Johnlon/spam-1/docs/rom-research.md

# ROM Research

Looking for large 16 bit wide ROM's for control logic and ALU purposes.

|Model|Description|Access|VCC Voltage|V other|Bit Address|Package|Link|
|---|---|---|-----|----|---|--|----|----|
|S29GL128S90TFI010|128 Mbit, 8M x 16bit, Parallel|100ns|3v abs max 4v|VSS+0.5|26 = 128MB, also 64/32/16MB options||TSOP, 56 Pins|https://uk.farnell.com/cypress-semiconductor/s29gl128s90tfi010/memory-flash-128mbit-56tsop/dp/2136248|
| | |  | | | | |https://www.mouser.co.uk/datasheet/2/671/MT28EW_QLLP_01G_ABA_0SIT-1287008.pdf

64k x 16 static ram - https://www.mouser.co.uk/datasheet/2/100/38-05462_CY7C1021D_1_MBIT_64K_X_16_STATIC_RAM-319200.pdf
