Johnlon/spam-1/docs/SimpleCpu-blocks-20200520.pptx

ALU A
Bus

_oe

A[15:0]

D[48:0]

ROM

D[7:0]

IMMEDIATE
ADDRESSSING

A

CONTROL LOGIC

D[48:8]

_wr
_oe

A[15:0]

RAM

BUFFER IN
_en

PCHITmp

CP

D

_en

Q

count_en
_pe

CP

D

PCHI

_MR

CP

count_en
_pe

D

PCLO

_MR

CP

D

_en

MARHI

BUFFER A
_en

MARLO

CP

D

_en

BUFFER A
_en

wr
_rd

UART

_txe
_rxf

BUFFER IN
_en

CONTROL LOGIC

BUFFER A
_en

CP

D

_MR

L

FLAGS

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
_cin

ALU

Address Bus [15:0]

D

Q

Q

Q

BUFFER AH
_en

Q

BUFFER AL
_en

D

rdL_addr
rdR_addr
wr_addr
_rdL_en
_rdR_en
_wr_en

SYNC
REG FILE

CONTROL
LOGIC

Result

PC [15:0]

BUFFER B
_en

D[24:16]

BUFFER AH
_en

BUFFER B
_en

BUFFER B
_en

BUFFER B
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
ALU B
Bus

B

DIRECT
ADDRESS HI

D[15:8]

BUFFER AL
_en

DIRECT
ADDRESS LO

PC [15:0]

REGISTER ADDRESS HI

REGISTER ADDRESS LO

Address Bus Hi [15:8]

Address Bus Lo [7:0]

8 Bit CPU Design

## Slide 2

ALU Result Bus

ALU A
Bus

_oe

A[15:0]

D[48:0]

ROM

D[7:0]

IMMEDIATE
ADDRESSSING

ram_alubus_buf

BUFFER IN
_en

marhi_abus_buf

marlo_abus_buf

BUFFER A
_en

uart_alubus_buf

uart_abus_buf

A

CONTROL LOGIC

BUFFER A
_en

BUFFER IN
_en

CONTROL LOGIC

BUFFER A
_en

PC [15:0]

ALU B
Bus

D[48:8]

_wr
_oe

A[15:0]

RAM

PCHITmp

CP

D

_en

Q

count_en
_pe

CP

D

PCHI

_MR

CP

count_en
_pe

D

PCLO

_MR

CP

D

_en

MARHI

MARLO

CP

D

_en

wr
_rd

UART

_txe
_rxf

rdL_addr
rdR_addr
wr_addr
_rdL_en
_rdR_en
_wr_en

CP

D

_MR

SYNC
REG FILE

L

FLAGS

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
_cin

ALU

Address Bus [15:0]

D

Q

Q

Q

BUFFER AH
_en

Q

BUFFER AL
_en

D

R

CONTROL
LOGIC

Result

BUFFER B
_en

BUFFER AH
_en

BUFFER B
_en

ram_bbus_buf

BUFFER B
_en

BUFFER B
_en

Optional extras: a presettable auto-counting MAR?
Or a settable address register that autoincrements after each read will save time on copy operations; otherwise multiple instructions required for increment, with carry to MARHI.
Basically a second program counter-like thing.
Dedicated stack pointer?.

C
Z
O
GT
LT
EQ
NE

rom_bbus_buf

BUFFER AL
_en

marhi_bbus_buf

REGISTER ADDRESS HI

marhi_addrbushi_buf

marhi_bbus_buf

REGISTER ADDRESS LO

B

DIRECT
ADDRESS HI

rom_addrbushi_buf

D[24:16]

D[15:8]

DIRECT
ADDRESS LO

rom_addrbuslo_buf

PC [15:0]

Address Bus Hi [15:8]

marlo_addrbuslo_buf

Address Bus Lo [7:0]

## Slide 3

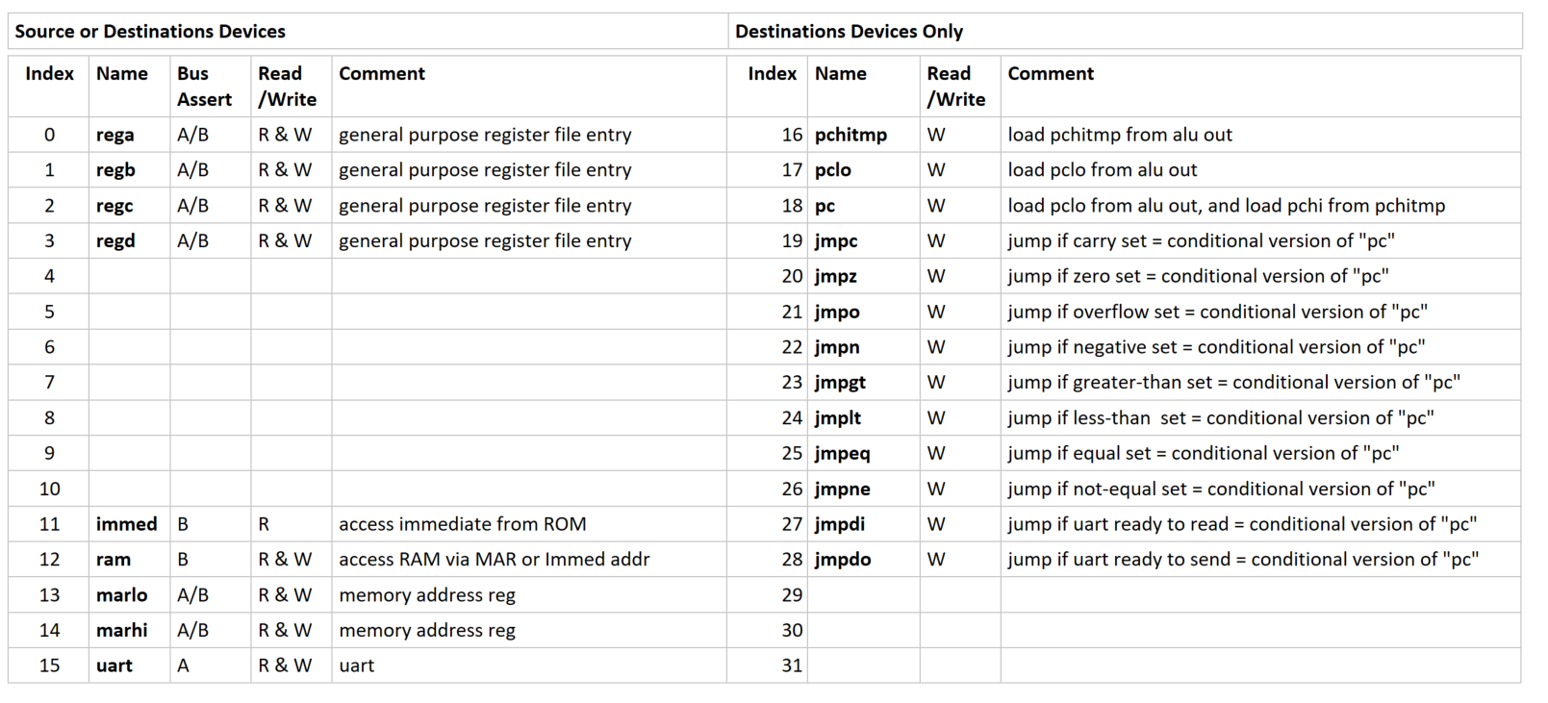
[picture p21: figure]

## Slide 4


## Slide 5

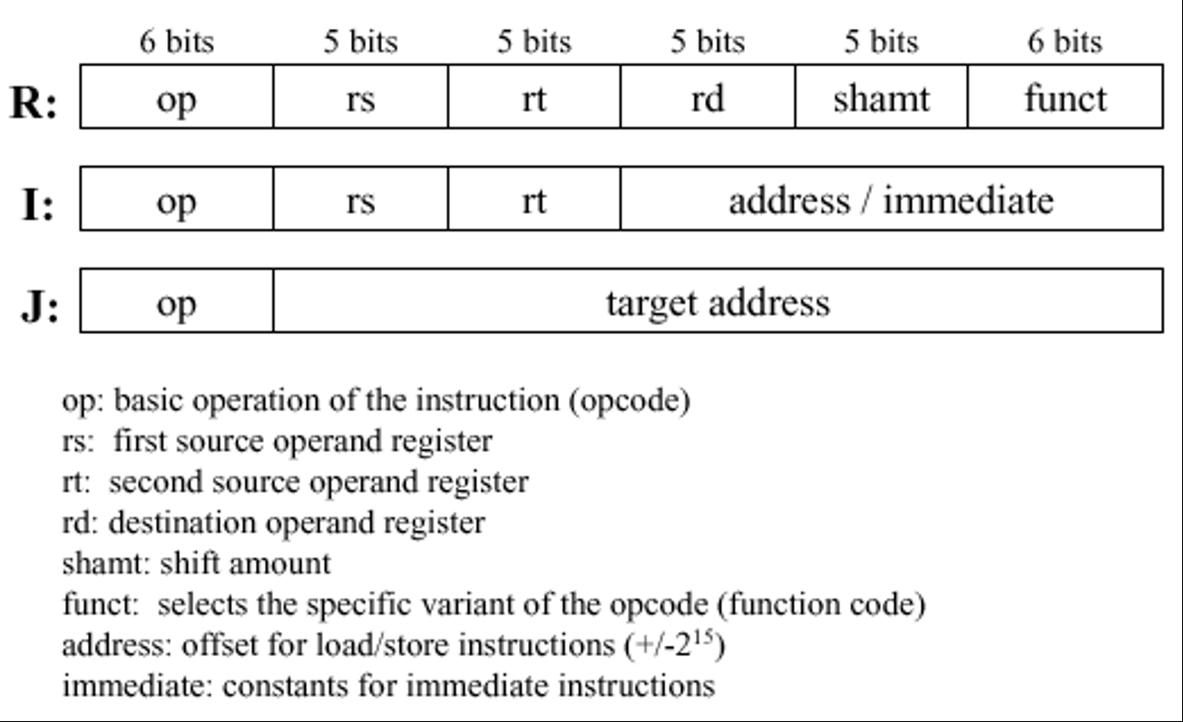
[picture p22: figure]

## Slide 6

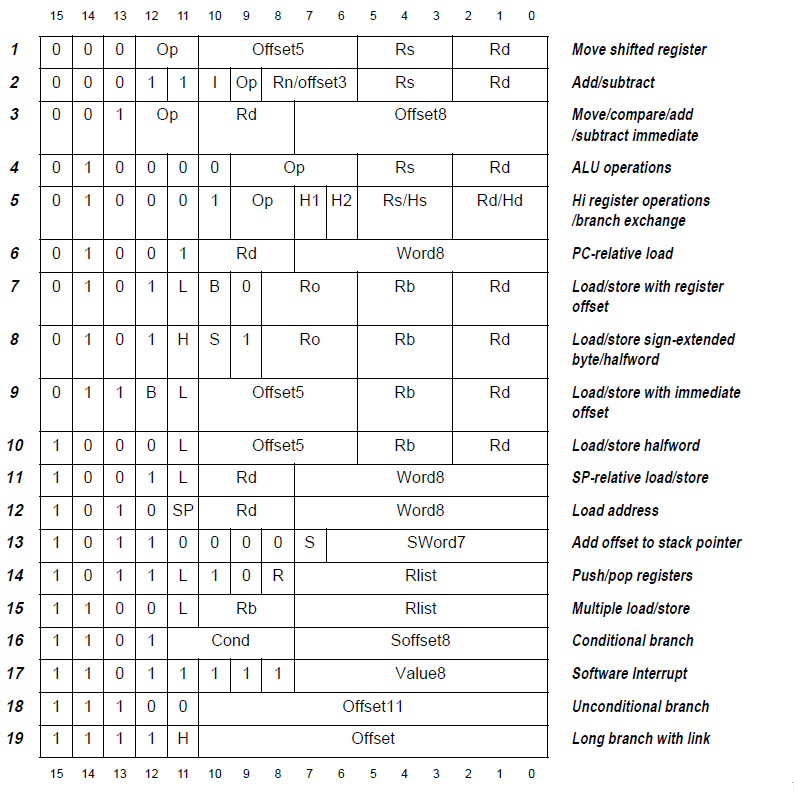
[picture p23: figure]
The art of emulation: Decoding the THUMB instruction set

## Slide 7

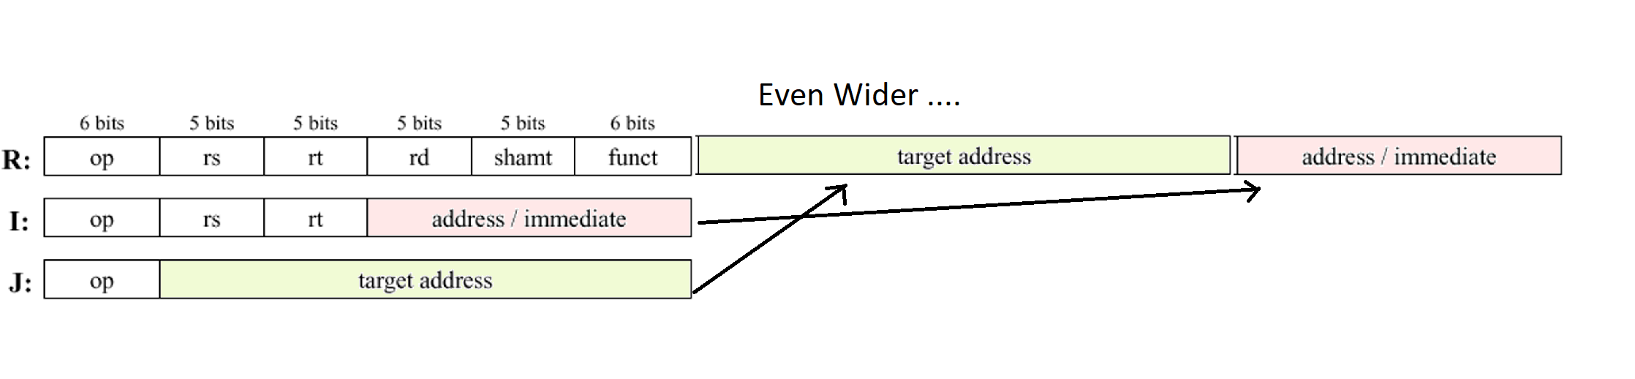
[picture p24: figure]
Even Wider J: op target address
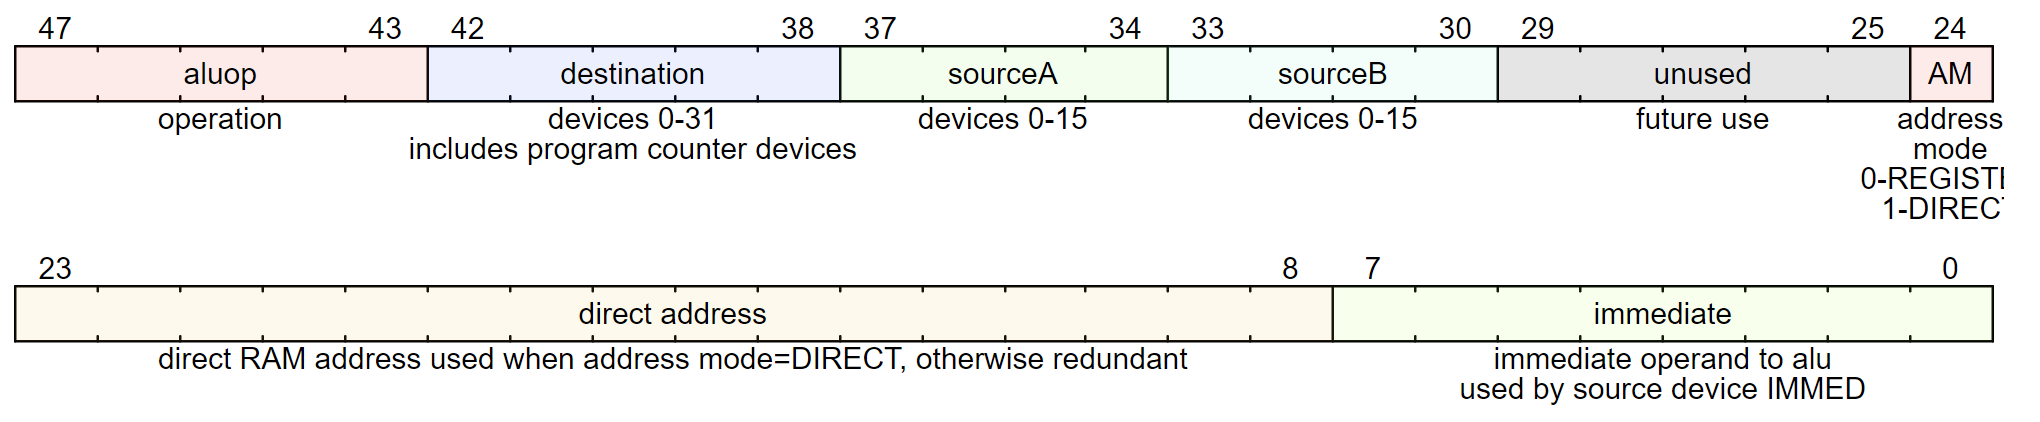
[picture p25: figure]
47 43 aluop operation 42 destination devices 0-31 38 37 34 33 sourced devices 0-1 30 29 25 24 AM devices 0-15 includes program counter devices direct address direct RAM address used when address mode-DIRECT otherwise redundant unused future use immediate address O-REGISTI I-DIREC immediate operand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

## Slide 8

Useful?? 74als576 – inverting dtype – oe + clk + bus layout
74HC7292 clock divider 4> 2billion – good for clock speed control off a fast crystal or for a freq counter - https://uk.rs-online.com/web/p/clock-dividers/5400461/

CAN NOT DO “RAM ALU IMMED” AS BOTH USE RBUS ONLY!

Horizontal Encoded “WIDE ROM” Design

Optional : Flags reg on A Bus means we can store it
to RAM or to another reg and do arbitrary bitwise comparisons on the result.
Optional: But if we also allow it to be restored from RAM or a REG or ROM then that
might be extra useful – eg to set or clear carry before arithmetic.
Or is Carry a special case? Perhaps on a sophisticated CPU
stashing the flags might be useful, but here?

General conditional instruction?
Set flags control like ARM?

RAM isolation from result bus to avoid read / write or RAM leaking between Result Bus and B Bus.
Buffer I _oe = _wr
Buffer B _oe = _RAM _oe

ALU Result Bus

ALU A Bus

ram_alubus_buf

marhi_abus_buf

marlo_abus_buf

uart_alubus_buf

uart_abus_buf

A

_oe

A[15:0]

D[48:0]

ROM

CONTROL LOGIC

D[48:8]

BUFFER IN
_en

BUFFER A
_en

BUFFER A
_en

BUFFER IN
_en

CONTROL LOGIC

UART Buffer isolation needed to prevent writes and reads from UART on one bus leaking over to the other bus.
Buffer IN _oe = wr
Buffer A _oe = _rd
(wr is +ve edge latch)

BUFFER A
_en

TBD: Flags Reg
write _en may only be enabled for specific ops

FLAGS

BUFFER A
_en`

PC [15:0]

_wr
_oe

A[15:0]

PCHITmp

CP

D

_en

Q

count_en
_pe

CP

D

PCHI

_MR

count_en
_pe

CP

D

PCLO

_MR

MARHI

CP

D

_en

MARLO

CP

D

_en

wr
_rd

UART

Register file is a general
purpose register set

rdL_addr
rdR_addr
wr_addr
_rdL_en
_rdR_en
_wr_en

CP

D

_MR

SYNC
REG FILE

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
_cin

ALU

Address Bus [15:0]

RAM

D

Q

Q

MAR primary function is Address Bus index.
Optionally MAR can join either/both A Bus
or B Bus depending
on flexibility desired.
So MAR also acts as a GP register on both ALUinput busses.

Q

BUFFER AH
_en

Q

BUFFER AL
_en

_txe
_rxf

D

R

CONTROL LOGIC

Result

Immediate
addressing
buffer

D[7:0]

BUFFER B
_en

ALU B Bus

rom_bbus_buf

D[24:16]

BUFFER AH
_en

BUFFER B
_en

ram_bbus_buf

PCHI/LO Primary function is Address Bus index.
Optionally PC can join either/both A Bus or B Bus depending on whether I want to permit PC arithmetic.
Here PC is shown outputting to
A Bus.

BUFFER B
_en

BUFFER B
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
BUFFER AL
_en

marhi_bbus_buf

MARHI

marhi_bbus_buf

Optional extras: a presettable auto-counting MAR?
Or a settable address register that autoincrements after each read will save time on copy operations; otherwise multiple instructions required for increment, with carry to MARHI. Basically a second program counter like thing.
And I have no dedicated stack pointer either.

B

DIRECTHI

rom_addrbushi_buf

D[15:8]

DIRECTLO

rom_addrbuslo_buf

Attach RAM /ROM to
R Bus so they can
participate in ALU
as other side from
the other registers
Or UART.

PC [15:0]

_oe=_addrmode_register

MARLO

Address Bus Hi [15:8]

CANNOT READ PROGRAM COUNTER : NOT NEEDED IN STATIC PROGRAM

marhi_addrbushi_buf

marlo_addrbuslo_buf

USE 40 pin ribbon and connector for busses?
20 pin for connector + 4x10 pin for chips = 60
Remaining 3 pins for caps? Or spacing?? Very tight.
So instead use the approach in the

Address Bus Lo [7:0]

BUS RIBBON CONNECTOR https://uk.rs-online.com/web/p/products/0471389/

GS100 bus stripx2 $3.45 https://www.globalspecialties.com/solderless-breadboards/breadboards-bus-strips/item/34-gs-100.html
£3.28 https://www.mouser.co.uk/ProductDetail/Global-Specialties/GS-100?qs=uv8bPZ39CeNa73a0uSX5Lw%3D%3D
BB100R is the busboard equiv
£2.70 https://www.digikey.co.uk/product-detail/en/global-specialties/GS-100/BKGS-100-ND/5231302

## Slide 9

RAM isolation from result bus to avoid read / write or RAM leaking between Result Bus and B Bus.
Buffer I _oe = _wr
Buffer B _oe = _RAM _oe

ALU Result Bus

Optional : Flags reg on A Bus means we can store it
to RAM or to another reg and do arbitrary bitwise comparisons on the result.
Optional: But if we also allow it to be restored from RAM or a REG or ROM then that
might be extra useful – eg to set or clear carry before arithmetic.
Or is Carry a special case? Perhaps on a sophisticated CPU
stashing the flags might be useful, but here?

ALU A Bus

ram_alubus_buf

pchi_abus_buf

pclo_abus_buf

marhi_abus_buf

marlo_abus_buf

uart_alubus_buf

uart_abus_buf

A

_oe

A[15:0]

D[48:0]

ROM

CONTROL LOGIC

D[48:8]

BUFFER IN
_en

BUFFER A
_en

BUFFER A
_en

BUFFER A
_en

BUFFER A
_en

BUFFER IN
_en

CONTROL LOGIC

UART Buffer isolation needed to prevent writes and reads from UART on one bus leaking over to the other bus.
Buffer IN _oe = wr
Buffer A _oe = _rd
(wr is +ve edge latch)

BUFFER A
_en

TBD: Flags Reg
write _en may only be enabled for specific ops

FLAGS

BUFFER A
_en`

PC [15:0]

_wr
_oe

A[15:0]

PCHITmp

CP

D

_en

Q

count_en
_pe

CP

D

PCHI

_MR

count_en
_pe

CP

D

PCLO

_MR

MARHI

CP

D

_en

MARLO

CP

D

_en

wr
_rd

UART

Register file is a general
purpose register set

rdL_addr
rdR_addr
wr_addr
_rdL_en
_rdR_en
_wr_en

CP

D

_MR

SYNC
REG FILE

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
_cin

ALU

Address Bus [15:0]

RAM

D

Q

Q

MAR primary function is Address Bus index.
Optionally MAR can join either/both A Bus
or B Bus depending
on flexibility desired.
So MAR also acts as a GP register on both ALUinput busses.

Q

BUFFER AH
_en

Q

BUFFER AL
_en

_txe
_rxf

D

R

CONTROL LOGIC

Result

Immediate
addressing
buffer

D[7:0]

BUFFER B
_en

ALU B Bus

rom_bbus_buf

D[24:16]

BUFFER AH
_en

BUFFER B
_en

ram_bbus_buf

PCHI/LO Primary function is Address Bus index.
Optionally PC can join either/both A Bus or B Bus depending on whether I want to permit PC arithmetic.
Here PC is shown outputting to
A Bus.

BUFFER B
_en

BUFFER B
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
BUFFER AL
_en

marhi_bbus_buf

MARHI

marhi_bbus_buf

Optional extras: a presettable auto-counting MAR?
Or a settable address register that autoincrements after each read will save time on copy operations; otherwise multiple instructions required for increment, with carry to MARHI. Basically a second program counter like thing.
And I have no dedicated stack pointer either.

B

DIRECTHI

rom_addrbushi_buf

D[15:8]

DIRECTLO

rom_addrbuslo_buf

Attach RAM /ROM to
R Bus so they can
participate in ALU
as other side from
the other registers
Or UART.

PC [15:0]

_oe=_addrmode_register

MARLO

Address Bus Hi [15:8]

marhi_addrbushi_buf

marlo_addrbuslo_buf

Address Bus Lo [7:0]

## Slide 10

~~This design doesn’t permit~~
~~X=Y+KONST~~ ~~or worse perhaps~~
~~X = X~~ ~~logicialOp~~ ~~KONST~~ FIXED

Use unused op 2 or 3 for that?
If not enough bit space then do X=X+5 so targ is fixed to src OR only permit lower 16 ALU ops HMM Bad for logic ops.
OR only allow 3 bits for src and/or targ so we can only do that with GP registers ??
Targ fixed to src is probably ok for many logical ops??

74als576 – inverting dtype – oe + clk + bus layout
74HC7292 clock divider 4> 2billion – good for clock speed control off a fast crystal or for a freq counter - https://uk.rs-online.com/web/p/clock-dividers/5400461/

Horizontal Encoded “WIDE ROM” Design

Optional : Flags reg on A Bus means we can store it
to RAM or to another reg and do arbitrary bitwise comparisons on the result.
Optional: But if we also allow it to be restored from RAM or a REG or ROM then that
might be extra useful – eg to set or clear carry before arithmetic.
Or is Carry a special case? Perhaps on a sophisticated CPU
stashing the flags might be useful, but here?

RAM isolation from result bus to avoid read / write or RAM leaking between Result Bus and B Bus.
Buffer I _oe = _wr
Buffer B _oe = _RAM _oe

ALU Result Bus

ALU A Bus

ram_alubus_buf

pchi_abus_buf

pclo_abus_buf

marhi_abus_buf

marlo_abus_buf

uart_alubus_buf

uart_abus_buf

A

Raw {PCHI, PCLO}

PC [15:0]

Address Bus
multiplexes
{PCHI, PCLO}
{MARHI, MARLO}
{DIRECTHI, DIRECTLO}

_oe

A[15:0]

D[48:8]

ROM

_oe

A D[7:0]

ROM

CONTROL LOGIC

BUFFER IN
_en

BUFFER A
_en

BUFFER A
_en

BUFFER A
_en

BUFFER A
_en

BUFFER IN
_en

CONTROL LOGIC

UART Buffer isolation needed to prevent writes and reads from UART on one bus leaking over to the other bus.
Buffer IN _oe = wr
Buffer A _oe = _rd
(wr is +ve edge latch)

BUFFER A
_en

TBD: Flags Reg
write _en may only be enabled for specific ops

FLAGS

BUFFER A
_en`

D[48:8]

Address Bus

_wr
_oe

A[15:0]

PCHITmp

CP

D

_en

Q

count_en
_pe

CP

D

PCHI

_MR

count_en
_pe

CP

D

PCLO

_MR

MARHI

CP

D

_en

MARLO

+ve edge Registers but could be latches if the output of the ALU is a register

CP

D

_en

wr
_rd

UART

Register file is a general
purpose register set

rdL_addr
rdR_addr
wr_addr
_rdL_en
_rdR_en
_wr_en

CP

D

_MR

SYNC
REG FILE

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
_cin

ALU

Address Bus [15:0]

D[7:0]

Instruction Reg
for low byte

IReg Lo
_en

RAM

D

Q

Q

MAR primary function is Address Bus index.
Optionally MAR can join either/both A Bus
or B Bus depending
on flexibility desired.
So MAR also acts as a GP register on both ALUinput busses.

Q

BUFFER AH
_en

Q

BUFFER AL
_en

_txe
_rxf

D

R

CONTROL LOGIC

Result

Direct
addressing
buffer

BUFFER B
_en

ALU B Bus

rom_bbus_buf

D[7:0]

D[24:16]

BUFFER AH
_en

BUFFER B
_en

Immediate
addressing
buffer

BUFFER B
_en

ram_bbus_buf

PCHI/LO Primary function is Address Bus index.
Optionally PC can join either/both A Bus or B Bus depending on whether I want to permit PC arithmetic.
Here PC is shown outputting to
A Bus.

BUFFER B
_en

BUFFER B
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
BUFFER AL
_en

instreg_bbus_buf

marhi_bbus_buf

MARHI

marhi_bbus_buf

Optional extras: a presettable auto-counting MAR?
Or a settable address register that autoincrements after each read will save time on copy operations; otherwise multiple instructions required for increment, with carry to MARHI. Basically a second program counter like thing.
And I have no dedicated stack pointer either.

B

DIRECTHI

rom_addrbushi_buf

D[15:8]

_oe=_addrmode_immediate

DIRECTLO

rom_addrbuslo_buf

Attach RAM /ROM to
R Bus so they can
participate in ALU
as other side from
the other registers
Or UART.

PCHI

pchi_addrbushi_buf

BUFFER AH
_en

BUFFER AL
_en

_oe=_addrmode_pc

PCLO

pclo_addrbuslo_buf

_oe=_addrmode_register

MARLO

Address Bus Hi [15:8]

marhi_addrbushi_buf

marlo_addrbuslo_buf

Address Bus Lo [7:0]

GS100 bus stripx2 $3.45 https://www.globalspecialties.com/solderless-breadboards/breadboards-bus-strips/item/34-gs-100.html
£3.28 https://www.mouser.co.uk/ProductDetail/Global-Specialties/GS-100?qs=uv8bPZ39CeNa73a0uSX5Lw%3D%3D
BB100R is the busboard equiv
£2.70 https://www.digikey.co.uk/product-detail/en/global-specialties/GS-100/BKGS-100-ND/5231302

## Slide 11

This design doesn’t permit
X=Y+KONST or worse perhaps
X = X logicialOp KONST FIXED

Use unused op 2 or 3 for that?
If not enough bit space then do X=X+5 so targ is fixed to src OR only permit lower 16 ALU ops HMM Bad for logic ops.
OR only allow 3 bits for src and/or targ so we can only do that with GP registers ??
Targ fixed to src is probably ok for many logical ops??

74als576 – inverting dtype – oe + clk + bus layout
74HC7292 clock divider 4> 2billion – good for clock speed control off a fast crystal or for a freq counter - https://uk.rs-online.com/web/p/clock-dividers/5400461/
FIX NAMES IMMEDIATE/DIRECT/REGISTER
CONTROL LOGIC EASIER IF ALL DEVICES CAN WRITE TO RBUS OR LBUS AS DON’T NEED TO FORCE L AND R JUST ONE OR THE OTHER

CAN’T DO “RAM ALU IMMED” AS BOTH USE RBUS ONLY!

Clock Circuit with Break - http://tinyurl.com/y3ygr5yr

Horizontal Encoded “WIDE ROM” Design

Optional : Flags reg on L Bus means we can store it
to RAM or to another reg and do arbitrary bitwise comparisons on the result.
Optional: But if we also allow it to be restored from RAM or a REG or ROM then that
might be extra useful – eg to set or clear carry before arithmetic.
Or is Carry a special case? Perhaps on a sophisticated CPU
stashing the flags might be useful, but here?

RAM isolation from result bus to avoid read / write or RAM leaking between Result Bus and R Bus.
Buffer I _oe = _wr
Buffer R _oe = _RAM _oe

ALU Result Bus

ALU A Bus

ram_alubus_buf

pchi_abus_buf

pclo_abus_buf

marhi_abus_buf

marlo_abus_buf

uart_alubus_buf

uart_abus_buf

A

Raw {PCHI, PCLO}

PC [15:0]

Address Bus
multiplexes
{PCHI, PCLO}
{MARHI, MARLO}
{DIRECTHI, DIRECTLO}

_oe

A[15:0]

D[48:8]

ROM

_oe

A D[7:0]

ROM

CONTROL LOGIC

BUFFER I
_en

BUFFER A
_en

BUFFER A
_en

BUFFER A
_en

BUFFER A
_en

BUFFER I
_en

CONTROL LOGIC

UART Buffer isolation needed to prevent writes and reads from UART on one bus leaking over to the other bus.
Buffer I _oe = wr
Buffer L _oe = _rd
(wr is +ve edge latch)

BUFFER A
_en

TBD: Flags Reg
write _en may only be enabled for specific ops

FLAGS

BUFFER A
_en`

D[48:8]

Address Bus

_wr
_oe

A[15:0]

PCHITmp

CP

D

_en

Q

count_en
_pe

CP

D

PCHI

_MR

count_en
_pe

CP

D

PCLO

_MR

MARHI

CP

D

_en

MARLO

+ve edge Registers but could be latches if the output of the ALU is a register

CP

D

_en

wr
_rd

UART

Register file is a general
purpose register set

rdL_addr
rdR_addr
wr_addr
_rdL_en
_rdR_en
_wr_en

CP

D

_MR

SYNC
REG FILE

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
_cin

ALU

Address Bus [15:0]

D[7:0]

Instruction Reg
for low byte

IReg Lo
_en

RAM

D

Q

Q

MAR primary function is Address Bus index.
Optionally MAR can join either/both L Bus
or R Bus depending
on flexibility desired.
So MAR also acts as a GP register on both ALUinput busses.

Q

BUFFER AH
_en

Q

BUFFER AL
_en

_txe
_rxf

D

R

CONTROL LOGIC

Result

Direct
addressing
buffer

BUFFER B
_en

ALU B Bus

rom_bbus_buf

D[7:0]

D[24:16]

BUFFER AH
_en

DIRECTHI

BUFFER B
_en

Immediate
addressing
buffer

BUFFER B
_en

ram_bbus_buf

PCHI/LO Primary function is Address Bus index.
Optionally PC can join either/both L Bus or R Bus depending on whether I want to permit PC arithmetic.
Here PC is shown outputting to
L Bus.

BUFFER B
_en

BUFFER B
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
BUFFER AL
_en

instreg_bbus_buf

marhi_bbus_buf

MARHI

marhi_bbus_buf

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

B

D[15:8]

_oe=_addrmode_immediate

DIRECTLO

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

PCHI

pchi_addrbushi_buf

BUFFER AH
_en

BUFFER AL
_en

_oe=_addrmode_pc

PCLO

pclo_addrbuslo_buf

_oe=_addrmode_register

MARLO

marlo_addrbuslo_buf

rom_addrbushi_buf

Address Bus Hi [15:8]

rom_addrbuslo_buf

marhi_addrbushi_buf

DONE!!
!!!! DON’T SET FLAGS WHEN OPERATION IS A JUMP (IE SETTING THOSE REG) AS IT MAKES
“IF NFLAG & CFLAG” logic impossible
!!! CANT WORK UNLESS FIX BECAUSE SETTING PCHITMP CLEARS THE CONDITION SO WE NEVER CONDITIONALLY JUMP

USE 40 pin ribbon and connector for busses?
20 pin for connector + 4x10 pin for chips = 60
Remaining 3 pins for caps? Or spacing?? Very tight.
So instead use the approach in the

Address Bus Lo [7:0]

GS100 bus stripx2 $3.45 https://www.globalspecialties.com/solderless-breadboards/breadboards-bus-strips/item/34-gs-100.html
£3.28 https://www.mouser.co.uk/ProductDetail/Global-Specialties/GS-100?qs=uv8bPZ39CeNa73a0uSX5Lw%3D%3D
BB100R is the busboard equiv
£2.70 https://www.digikey.co.uk/product-detail/en/global-specialties/GS-100/BKGS-100-ND/5231302

## Slide 12

This design doesn’t permit
X=Y+KONST or worse perhaps
X = X logicialOp KONST FIXED
Use unused op 2 or 3 for that?
If not enough bit space then do X=X+5 so targ is fixed to src OR only permit lower 16 ALU ops HMM Bad for logic ops.
OR only allow 3 bits for src and/or targ so we can only do that with GP registers ??
Targ fixed to src is probably ok for many logical ops??

74als576 – inverting dtype – oe + clk + bus layout
74HC7292 clock divider 4> 2billion – good for clock speed control off a fast crystal or for a freq counter - https://uk.rs-online.com/web/p/clock-dividers/5400461/
FIX NAMES IMMEDIATE/DIRECT/REGISTER
CONTROL LOGIC EASIER IF ALL DEVICES CAN WRITE TO RBUS OR LBUS AS DON’T NEED TO FORCE L AND R JUST ONE OR THE OTHER

If I postpone being able to write
to more than one bus then I don’t
need to wire in the Buffer L/R devices.
Eg if the reg’s write to L and ROM/RAM to R
Then I think that’s a simplification especially
If PC and MAR can’t be read via ALU

RAM isolation from result bus to avoid read / write or RAM leaking between Result Bus and R Bus.
Buffer I _oe = _wr
Buffer R _oe = _RAM _oe

ALU Result Bus

Optional : Flags reg on L Bus means we can store it
to RAM or to another reg and do arbitrary bitwise comparisons on the result.
Optional: But if we also allow it to be restored from RAM or a REG or ROM then that
might be extra useful – eg to set or clear carry before arithmetic.
Or is Carry a special case? Perhaps on a sophisticated CPU
stashing the flags might be useful, but here?

ALU L Bus

ram_alubus_buf

pchi_abus_buf

pclo_abus_buf

marhi_abus_buf

marlo_abus_buf

uart_alubus_buf

uart_abus_buf

L

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

CONTROL LOGIC

BUFFER I
_en

BUFFER A
_en

BUFFER A
_en

BUFFER A
_en

BUFFER A
_en

BUFFER I
_en

CONTROL LOGIC

UART Buffer isolation needed to prevent writes and reads from UART on one bus leaking over to the other bus.
Buffer I _oe = wr
Buffer L _oe = _rd
(wr is +ve edge latch)

BUFFER A
_en

TBD: Flags Reg
write _en may only be enabled for specific ops

FLAGS

BUFFER A
_en`

A/16

_oe

D[23:16]

A[15:0]

D[15:0]

ROM

D[23:16]

Latches

IReg Hi
_en

A/16

_wr
_oe

A[15:0]

PCHITmp

CP

D

_en

Q

count_en
_pe

CP

D

PCHI

_MR

count_en
_pe

CP

D

PCLO

_MR

MARHI

CP

D

_en

MARLO

+ve edge Registers but could be latches if the output of the ALU is a register

CP

D

_en

wr
_rd

UART

Register file is a general
purpose register set

rdL_addr
rdR_addr
wr_addr
_rdL_en
_rdR_en
_wr_en

CP

D

_MR

SYNC
REG FILE

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
_cin

ALU

D[15:8]

D[7:0]

IReg Mid
_en

IReg Lo
_en

RAM

D

Q

Q

MAR primary function is Address Bus index.
Optionally MAR can join either/both L Bus
or R Bus depending
on flexibility desired.
So MAR also acts as a GP register on both ALUinput busses.

Q

BUFFER AH
_en

Q

BUFFER AL
_en

_txe
_rxf

D

R

CONTROL LOGIC

Result

D[7:0]

BUFFER B
_en

ALU R Bus

rom_bbus_buf

D[15:8]

BUFFER AH
_en

BUFFER B
_en

BUFFER B
_en

ram_bbus_buf

PCHI/LO Primary function is Address Bus index.
Optionally PC can join either/both L Bus or R Bus depending on whether I want to permit PC arithmetic.
Here PC is shown outputting to
L Bus.

BUFFER B
_en

BUFFER B
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
BUFFER AL
_en

instreg_bbus_buf

marhi_bbus_buf

marhi_bbus_buf

R

D[7:0]

_oe=_addrmode_immediate

rom_addrbuslo_buf

BUFFER AH
_en

BUFFER AL
_en

_oe=_addrmode_pc

pclo_addrbuslo_buf

_oe=_addrmode_register

marlo_addrbuslo_buf

Optional extras: a presettable auto-counting MAR?

Address Bus (A/16)

rom_addrbushi_buf

Address Bus Hi / 8

pchi_addrbushi_buf

marhi_addrbushi_buf

!!!! DON’T SET FLAGS WHEN OPERATION IS A JUMP (IE SETTING THOSE REG) AS IT MAKES
“IF NFLAG & CFLAG” logic impossible
!!! CANT WORK UNLESS FIX BECAUSE SETTING PCHITMP CLEARS THE CONDITION SO WE NEVER CONDITIONALLY JUMP

Address Bus Lo / 8

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

USE 40 pin ribbon and connector for busses?
20 pin for connector + 4x10 pin for chips = 60
Remaining 3 pins for caps? Or spacing?? Very tight.
So instead use the approach in the

## Slide 13

ALU Result Bus

Optional : Flags reg on L Bus means we can store it
to RAM or to another reg and do arbitrary bitwise comparisons on the result.
Optional: But if we also allow it to be restored from RAM or a REG or ROM then that
might be extra useful – eg to set or clear carry before arithmetic.
Or is Carry a special case? Perhaps on a sophisticated CPU
stashing the flags might be useful, but here?

ALU L Bus

ram_alubus_buf

RAM isolation from result bus to avoid read / write or RAM leaking between Result Bus and R Bus.
Buffer I _oe = _wr
Buffer R _oe = _RAM _oe

uart_alubus_buf

uart_abus_buf

pchi_abus_buf

pclo_abus_buf

marhi_abus_buf

BUFFER A
_en

marlo_abus_buf

L

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

BUFFER I
_en

BUFFER I
_en

CONTROL LOGIC

UART Buffer isolation needed to prevent writes and reads from UART on one bus leaking over to the other bus.
Buffer I _oe = wr
Buffer L _oe = _rd
(wr is +ve edge latch)

BUFFER A
_en

BUFFER A
_en

BUFFER A
_en

BUFFER A
_en

TBD: Flags Reg
write _en may only be enabled for specific ops

FLAGS

BUFFER A
_en`

Address Bus (A/16)

A/16

_oe

D[23:16]

A[15:0]

D[15:0]

ROM

CONTROL LOGIC

A/16

_wr
_oe

A[15:0]

wr
_rd

UART

PCHITmp

CP

D

_en

Q

count_en
_pe

CP

D

PCHI

_MR

count_en
_pe

CP

D

PCLO

_MR

MARHI

CP

D

_en

MARLO

CP

D

_en

Register file is a general
purpose register set

rdL_addr
rdR_addr
wr_addr
_rdL_en
_rdR_en
_wr_en

CP

D

_MR

SYNC
REG FILE

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
_cin

ALU

D[15:8]

BUFFER AH
_en

RAM

D

_txe
_rxf

D

Q

Q

MAR primary function is Address Bus index.
Optionally MAR can join either/both L Bus
or R Bus depending
on flexibility desired.
So MAR also acts as a GP register on both ALUinput busses.

Q

BUFFER AH
_en

Q

BUFFER AL
_en

R

Optional extras: a presettable auto-counting MAR?

CONTROL LOGIC

Result

D[7:0]

BUFFER B
_en

ALU R Bus

rom_bbus_buf

BUFFER B
_en

ram_bbus_buf

PCHI/LO Primary function is Address Bus index.
Optionally PC can join either/both L Bus or R Bus depending on whether I want to permit PC arithmetic.
Here PC is shown outputting to
L Bus.

BUFFER B
_en

BUFFER B
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
BUFFER AL
_en

marhi_bbus_buf

_addrmode_register

marhi_bbus_buf

R

_addrmode_immediate

D[7:0]

_addrmode_pc

pchi_addrbushi_buf

BUFFER AH
_en

BUFFER AL
_en

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

rom_addrbushi_buf

Address Bus Hi / 8

rom_addrbuslo_buf

pclo_addrbuslo_buf

marhi_addrbushi_buf

marlo_addrbuslo_buf

Address Bus Lo / 8

Must be tristate register
to save a chip

## Slide 14

ALU Result Bus

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

ALU L Bus

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

L

BUFFER I
_en

BUFFER I
_en

CONTROL LOGIC

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

BUFFER A
_en

BUFFER A
_en

BUFFER A
_en

BUFFER A
_en

BUFFER A
_en

TBD: Flags Reg
write _en may only be enabled for specific ops

FLAGS

BUFFER A
_en`

ALU

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

Address Bus (A/16)

A/16

D[23:16]

A[15:0]

D[15:0]

ROM

CONTROL LOGIC

A/16

_wr
_oe

A[15:0]

D

wr
_rd

UART

D

PCHITmp

CP

D

_en

Q

count_en
_pe

CP

D

PCHI

_MR

Q

count_en
_pe

CP

D

PCLO

_MR

Q

MARHI

CP

D

_en

Q

BUFFER AH
_en

MARLO

CP

D

_en

Q

BUFFER AL
_en

Register file is a general
purpose register set

rdL_addr
rdR_addr
wr_addr
_rdL_en
_rdR_en
_wr_en

CP

D

_MR

SYNC
REG FILE

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
_cin

Result

D[7:0]

D[15:8]

BUFFER AH
_en

RAM

_txe
_rxf

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

R

Optional extras: a presettable autocounting MAR?

CONTROL LOGIC

C
Z
O
GT
LT
EQ
NE

ALU R Bus

BUFFER B
_en

BUFFER B
_en

BUFFER B
_en

BUFFER B
_en

R

BUFFER AL
_en

D[7:0]

BUFFER AH
_en

BUFFER AL
_en

Address Bus Hi / 8

Address Bus Lo / 8

_oe

## Slide 15

ALU Result Bus

ALU L Bus

RAM isolation from result bus to avoid read / write or RAM leaking between Result Bus and R Bus.
Buffer I _oe = _wr
Buffer O _oe = _RAM _oe

A/16

A

BUFFER I

CONTROL LOGIC

BUFFER I

BUFFER O

BUFFER

BUFFER

BUFFER

BUFFER

ALU

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

Address Bus (A/16)

A/16

D[23:16]

D[15:0]

A

BUFFER

CONTROL LOGIC

_wr
_oe

A

D

BUFFER O

UART

_txe
_rxf
wr
_rd

D

PCHITmp

CP

D

_en

Q

count_en
_pe

CP

D

PCHI

_MR

Q

count_en
_pe

CP

D

PCLO

_MR

Q

MARHI

CP

D

_en

Q

BUFFER

MARLO

CP

D

_en

Q

BUFFER

Register file is a general
purpose register set

rdL_addr
rdR_addr
wr_addr
_rdL_en
_rdR_en
_wr_en

CP

D

_MR

SYNC
REG FILE

A

Result

ROM

D[7:0]

D[15:8]

BUFFER

RAM

Buffer isolation needed to prevent writes and reads from UART on one bus leaking over to the other bus.
Buffer I _oe = wr
Buffer O _oe = _rd

(wr is +ve edge latch)

PC can join L Bus or R Bus or neither bus depending on whether I want to permit PC arithmetic in addition to its primary Address Bus function.
Here PC only outputs to
L Bus.

MAR can join either L Bus
or R Bus or both or
neither bus depending
on flexibility desired.
Here MAR is a GP
register on both ALU
input busses but
has additional
Address Bus function

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
FLAGS

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
CONTROL LOGIC

ALU R Bus

BUFFER

BUFFER

B

D[7:0]

BUFFER

BUFFER

BUFFER

Address Bus Hi

Address Bus Lo

## Slide 16

Data

Program Counter & ROM

JMP $1234
PCHIin=En PCHI _TMP = ROMOUT = 12
JMPin=En PCLO = ROMOUT = 34 PCHI=PCHI_TMP=12
JCS $1234
PCHIin=En PCHI _TMP =BUS = 12
IF-CS JMPin=En PCLO = BUS = 34 PCHI=PCHI_TMP=12
ROM Three x AT28C256-15PU = 96k ROM addressed as 15 bits

Data – tri-state buffer

Flags

Control line in

Control line out

Register File
and ALU

ADAPTED TO 16 BIT ADDRESS AND MORE GP REGISTERS

Output device

Control Logic

SN74HCT74N
Needed for MR
circuit

RAM

PCHI
TMP

D

PCHITmp in

(4) REG Y addr

(4)REG X addr

X

D

Y

REG in

ROM
data

MARLO in

Each PC =
2x74HC163
Vs
2x74HCT193
??

PCLO in

PCLO

D

PCHI

D

PCHi in

Flags In
same as
ALU out

Carry, Zero , Equals, Overflow

FLAGS
C, Z, E

flags

CU

Carry in

X

Y

RAMZP

D OE

ZP BUF

RAMZP

OE D C

MARLO

MARHI in

RAMZP

C D OE

MARHI

Both MAR use 74574
74 547 uses CP (no WE) so system CP is gated by an enable line

To support zero page addressing -
0 pulldown resistors effective when MARHI OE is disabled

Reset

Reset

[control lines out]

Op code

N bit ALU select
?5 Muxed with C?

flags

ALU

74244 buffer

DISPLAY
DEVICE

ROM out

AL/AH

ROM

BUF

AL/AH

RAM

RAM in

IN ready

UART

D

UART in

D

ROM
data

ALU out

D

RAM out

OUT ready

D

UART out

Not enough control bits for ALU – only 2 but 3 or 4 really needed + 1 for the carry in.
Also ought to be able to clear flags register, or at least clear carry perhaps?
Cant add/sub/logic Immediate
Cant do Add/Sub with and without observing the carry.
2 ALU bits, 3 bits out ctl (#7 is unused), 3 bits in ctl.
Also Warren suggested making the DISP bidirectional – see the UART.
And only got 2 general purpose registers – 3 or 4 much more flexible.
No signed arithmetic and no overflow.
Low ROM byte wasted for all but Immediate access – can byte be used for control lines otherwise?

BUS

Useless instructions in decoder??
Cannot carry program in RAM – do I want program in RAM?
PC incrementer requires an 8 bit adder probably – cos PC is 8 bits and this will only get worse if we go to 16 bits address - and the +1 input to added probably has to be the same width. So switch adder/mux circuit for an 8 or 16 bit loadable counter (8 bits hi and 8 bits lo PC like CSC but how does PC work in CSCvon8?). Still need a line for PC-in though.
Since “Flags in” = “ALU out” we cannot set flags without emitting ALU to bus. So can’t set flags using a compare instruction with an immediate or with a value from RAM or anywhere else. FlagsIn=ALUout was done to preserve flags during non ALU operations. << unless mux ROM/RAM into the alu inputsnote

## Slide 17

PCHI
TMP

D

PCHI in

MARLO in

MARHI in

OE D C

MARLO

Both MAR use 74574
74 547 uses CP (no WE) so system CP is gated by an enable line

JMP in

PCLO

D

JMP in

RAMZP

D OE

ZP BUF

RAMZP

RAMZP

C D OE

MARHI

Ov
Pull

To support zero page addressing -
0 pulldown resistors effective when MARHI OE is disabled

PCHI

D

74244 buffer

AL/AH

ROM

AL/AH

RAM

RAM in

ROM out

D

D

ROM
LOW8

BUF

(4)REG X addr

D

D

RAM out

Y

X

BUF

Carry, Zero , Equals, Overflow

FLAGS
C, Z, E

flags

CU

Control Logic

(4) REG Y addr

D in

REG in

Flags In
same as
ALU out

flags

Carry in

ALU

Y

X

[control lines out]

Op code

N bit ALU select
?5 Muxed with C?

DISPLAY
DEVICE

D

ALU out

BUF

OUT ready

IN ready

UART

UART out

UART in

BUS

D

Program Counter & ROM

Register File
and ALU

RAM

Output device

## Slide 18

Data

Program Counter & ROM

JMP $1234
PCHIin=En PCHI _TMP = ROMOUT = 12
JMPin=En PCLO = ROMOUT = 34 PCHI=PCHI_TMP=12
JCS $1234
PCHIin=En PCHI _TMP =BUS = 12
IF-CS JMPin=En PCLO = BUS = 34 PCHI=PCHI_TMP=12
ROM Three x AT28C256-15PU = 96k ROM addressed as 15 bits

Data – tri-state buffer

Flags

Control line in

Control line out

Register File
and ALU

ADAPTED TO 16 BIT ADDRESS AND MORE GP REGISTERS

Output device

Control Logic

RAM

(2)REG L addr

PCHI
TMP

D

PCHI in

(2) REG W addr

(2) REG R addr

L

D

R

REG in

ROM
data

MARLO in

JMP in

PCLO

D

PCHI

D

JMP in

Flags In
same as
ALU out

Carry, Zero , Equals, Overflow

FLAGS
C, Z, E

flags

CU

Carry in

L

R

RAMZP

D OE

ZP BUF

RAMZP

OE D C

MARLO

MARHI in

RAMZP

C D OE

MARHI

Both MAR use 74574
74 547 uses CP (no WE) so system CP is gated by an enable line

To support zero page addressing -
0 pulldown resistors effective when MARHI OE is disabled

[control lines out]

Op code

N bit ALU select
?5 Muxed with C?

flags

ALU

74244 buffer

DISPLAY
DEVICE

ROM out

AL/AH

ROM

BUF

AL/AH

RAM

RAM in

IN ready

UART

D

UART in

D

ROM
data

ALU out

D

RAM out

OUT ready

D

UART out

Not enough control bits for ALU – only 2 but 3 or 4 really needed + 1 for the carry in.
Also ought to be able to clear flags register, or at least clear carry perhaps?
Cant add/sub/logic Immediate
Cant do Add/Sub with and without observing the carry.
2 ALU bits, 3 bits out ctl (#7 is unused), 3 bits in ctl.
Also Warren suggested making the DISP bidirectional – see the UART.
And only got 2 general purpose registers – 3 or 4 much more flexible.
No signed arithmetic and no overflow.
Low ROM byte wasted for all but Immediate access – can byte be used for control lines otherwise?

BUS

Useless instructions in decoder??
Cannot carry program in RAM – do I want program in RAM?
PC incrementer requires an 8 bit adder probably – cos PC is 8 bits and this will only get worse if we go to 16 bits address - and the +1 input to added probably has to be the same width. So switch adder/mux circuit for an 8 or 16 bit loadable counter (8 bits hi and 8 bits lo PC like CSC but how does PC work in CSCvon8?). Still need a line for PC-in though.
Since “Flags in” = “ALU out” we cannot set flags without emitting ALU to bus. So can’t set flags using a compare instruction with an immediate or with a value from RAM or anywhere else. FlagsIn=ALUout was done to preserve flags during non ALU operations. << unless mux ROM/RAM into the alu inputsnote

## Slide 19

Data

Data – tri-state buffer

ROM

Out control line

In control line

Registers and ALU

Other control line

RAM

Program Counter

Control Logic

Output device

ADD1

D+1

D

PC in

PC

1

0

A in

A

B

B in

D

Flags in
= ALU out

Carry, Zero , Equals

FLAGS
C, Z, E

ROM out

[control lines]

2 bit ALU select

C & Z & E

A out

ALU

B out

MAR

D

MAR in

RAM in

RAM out

DISPLAY
DEVICE

PC out

BUF

ROM

A

C & Z & E

CU

BUF

BUF

ALU out

BUF

RAM

A

BUF

MAR out

DISP
REG

D

DISP in

[tri-state]

D

Op code

D

D

DISP out

Not enough control bits for ALU – only 2 but 3 or 4 really needed + 1 for the carry in.
Also ought to be able to clear flags register, or at least clear carry perhaps?
Cant add/sub/logic Immediate
Cant do Add/Sub with and without observing the carry.
2 ALU bits, 3 bits out ctl (#7 is unused), 3 bits in ctl.
Also Warren suggested making the DISP bidirectional – see the UART.
And only got 2 general purpose registers – 3 or 4 much more flexible.
No signed arithmetic and no overflow.
Low ROM byte wasted for all but Immediate access – can byte be used for control lines otherwise?

BUS

Useless instructions in decoder??
Cannot carry program in RAM – do I want program in RAM?
PC incrementer requires an 8 bit adder probably – cos PC is 8 bits and this will only get worse if we go to 16 bits - and the +1 input probably has to be the same width. So switch adder/mux circuit for an 8 or 16 bit loadable counter (8 bits hi and 8 bits lo PC like CSC but how does PC work in CSCvon8?). Still need a line for PC-in though.
Since Flags in = ALU out we cannot set flags without emitting ALU to bus. So can’t set flags using a compare instruction with an immediate or with a value from RAM or anywhere else. FlagsIn=ALUout was done to preserve flags during non ALU operations.
Need more control lines meaning only use low rom for immediate values when required and rest of time use low rom as control lines

## Slide 20

Data

Program Counter & ROM

Data – tri-state buffer

Flags

Control line in

Control line out

Register File
and ALU

Control Logic

RAM

Output device

ADAPTED TO 16 BIT ADDRESS AND MORE GP REGISTERS

(2)REG L addr

1

PCHI
TMP

D

PCHI TMP in

(2) REG W addr

(2) REG R addr

L

D

R

REG in

PCLO in

PCLO

D

PCHI

D

PCHI in

Flags in
= ALU out

Carry, Zero , Equals

FLAGS
C, Z, E

Carry in

L

R

MARLO in

MARLO

D

MARHI

D

MARHI in

[control lines out]

Op code

N bit ALU select
?5 Muxed with C?

C & Z & E

ALU

DISPLAY
DEVICE

ROM out

A (16)

ROM

C & Z & E

CU

BUF

A(16)

RAM

RAM in

IN ready

UART

D

UART in

D

ALU out

D

RAM out

OUT ready

D

UART out

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

BUS

Useless instructions in decoder??
Cannot carry program in RAM – do I want program in RAM?
PC incrementer requires an 8 bit adder probably – cos PC is 8 bits and this will only get worse if we go to 16 bits address - and the +1 input to added probably has to be the same width. So switch adder/mux circuit for an 8 or 16 bit loadable counter (8 bits hi and 8 bits lo PC like CSC but how does PC work in CSCvon8?). Still need a line for PC-in though.
Since “Flags in” = “ALU out” we cannot set flags without emitting ALU to bus. So can’t set flags using a compare instruction with an immediate or with a value from RAM or anywhere else. FlagsIn=ALUout was done to preserve flags during non ALU operations.

## Slide 21

Data

Data – tri-state buffer

ROM

Out control line

In control line

Registers and ALU

Other control line

RAM

Program Counter

Control Logic

Output device

ADD1

D+1

D

Needed for 16 bit address

ADDR HI

D

ADDR LO

D

PC in

PC

1

0

A in

A

B

B in

D

Flags in
= ALU out

Carry, Zero , Equals

FLAGS
C, Z, E

ROM out

[control lines]

C & Z & E

2 bit ALU select
0 : A+B
1 : A-B
2 : PASS A
3 : PASS B

ALU

MAR

D

MAR in

RAM in

RAM out

DISPLAY
DEVICE

PC out

BUF

ROM

A

C & Z & E

CU

BUF

ALU out

RAM

A

BUF

MAR out

DISP
REG

D

DISP in

[tri-state]

D

Op code

D

D

DISP out

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

BUS

Useless instructions in decoder??
Cannot carry program in RAM – do I want program in RAM?
PC incrementer requires an 8 bit adder probably – cos PC is 8 bits and this will only get worse if we go to 16 bits address - and the +1 input to added probably has to be the same width. So switch adder/mux circuit for an 8 or 16 bit loadable counter (8 bits hi and 8 bits lo PC like CSC but how does PC work in CSCvon8?). Still need a line for PC-in though.
Since Flags in = ALU out we cannot set flags without emitting ALU to bus. So can’t set flags using a compare instruction with an immediate or with a value from RAM or anywhere else. FlagsIn=ALUout was done to preserve flags during non ALU operations.
Need more control lines meaning only use low rom for immediate values when required and rest of time use low rom as control lines

## Slide 22

Data

Data – tri-state buffer

ROM

Out control line

In control line

Registers and ALU

Other control line

RAM

Program Counter

Control Logic

Output device

ADD1

D+1

D

PC in

PC

1

0

A in

A

B

B in

D

Carry, Zero , Equals

FLAGS
C, Z, E

C & Z & E

CU

ROM out

[control lines]

Flags in

2 bit ALU select

C & Z & E

A out

ALU

B out

MAR

D

MAR in

RAM in

RAM out

DISPLAY
DEVICE

PC out

BUF

ROM

A

BUF

BUF

ALU out

BUF

RAM

A

BUF

MAR out

DISP
REG

D

DISP in

[tri-state]

D

Op code

D

D

BUS

Inefficient use of control lines around register and ALU.
2 ALU bits, 3 bits out ctl (#7 is unused), 3 bits in ctl.
If we take #7 out plus Aout and Bout lines away

## Slide 23

Program Counter

ROM

Control Logic

Registers and ALU

RAM

Output device

ADD1

D+1

D

A in

PC in

PC

1

0

D

C

A

B

B in

D

Carry, Zero , Equals

FLAGS
C, Z, E

C & Z & E

CU

MAR

D

MAR in

RAM in

RAM out

ROM out

[control lines]

Flags in

2 bit ALU select

C & Z & E

ALU

DISPLAY
DEVICE

MAR out

PC out

BUF

ROM

A

ALU out

BUF

RAM

A

BUF

DISP
REG

D

DISP in

[tri-state]

D

Op code

D

D

BUS

Data

Data – tri-state buffer

In/Out control line

Other control line

## Slide 24

Mux:Support relative jumps

Control Logic

Mux: Support immediate arith (without loading reg)

Mux: Support walking memory locations

Program Counter

ADD1

D+1

D

PC in

1

0

A in

A

B

B in

PC

D

Flags in

Carry, Zero ( Negative, Overflow,
Magnitude?? )

FLAGS
C & Z

C & Z

CU

[All other control]

C & Z

ALU sel
(4 + M & C)

ALU

MAR

D

MAR in

DISPLAY
DEVICE

DISP
REG

DISP in

D

PC out

BUF

ROM out

ROM

A

ALU out

BUF

RAM

A

RAM in

RAM out

BUF

MAR out

D

D

Op code

D

BUS

Could we take a lines from the ram and other components straight into the ALU via a MUX and avoid the bus?
Can I support an update in place with arbitrary registers
RegX = ALU(Reg Y, Reg Z)
Can I add immediate to a reg without having the added value from the rom go via a reg? Ie “ADD RA, 10” add 10 to RA without overwriting RB
Might need to introduce an instruction register to hold the immediate value “10” to do that??

## Slide 25

Program Counter

ROM

Control Logic

Registers and ALU

RAM

Output device

ADD1

D+1

D

PC in

PC

1

0

A in

A

B

B in

D

Carry, Zero , Equals

FLAGS
C, Z, E

C & Z & E

CU

MAR

D

ROM out

[control lines]

Flags in

2 bit ALU select

C & Z & E

ALU

MAR in

RAM in

RAM out

DISPLAY
DEVICE

PC out

BUF

ROM

A

ALU out

BUF

RAM

A

BUF

MAR out

DISP
REG

D

DISP in

[tri-state]

D

Op code

D

D

BUS

Mux:Support relative jumps

Mux: Support immediate arith (without loading reg)

Mux: Support walking memory locations

Could we take a lines from the ram and other components straight into the ALU via a MUX and avoid the bus?
Can I add immediate to a reg without having the added value from the rom go via a reg? Ie “ADD RA, 10” add 10 to RA without overwriting RB
Might need to introduce an instruction register to hold the immediate value “10” to do that or mux the ROM data into the ALU.
