Johnlon/spam-1/jvmtools/compiler/programs/README.md

To run the chip sim on the verilog sim then 

- Run the UARTTerminal so that the uart out file is being monitored.

- Ensure that the Chip8Emulator.scc file is including the IBM_Logo.ch8
    $200 : [file("/home/john/OneDrive/github/johnlon/chip-8/src/main/resources/chip8/roms/IBM_Logo.ch8")]
- Compile the Chip8 program and run it in the sim
  - cd programs
  - ./run

   ................................................................................................................................
   ........................████████████████..██████████████████......██████████..................██████████........................
   ................................................................................................................................
   ........................████████████████..██████████████████████..████████████..............████████████........................
   ................................................................................................................................
   ............................████████..........██████......██████......██████████..........██████████............................
   ................................................................................................................................
   ............................████████..........██████████████..........██████████████..██████████████............................
   ................................................................................................................................
   ............................████████..........██████████████..........██████..██████████████..██████............................
   ................................................................................................................................
   ............................████████..........██████......██████......██████....██████████....██████............................
   ................................................................................................................................
   ........................████████████████..██████████████████████..██████████......██████......██████████........................
   ................................................................................................................................
