Johnlon/spam-1/docs/logo-digits.docx

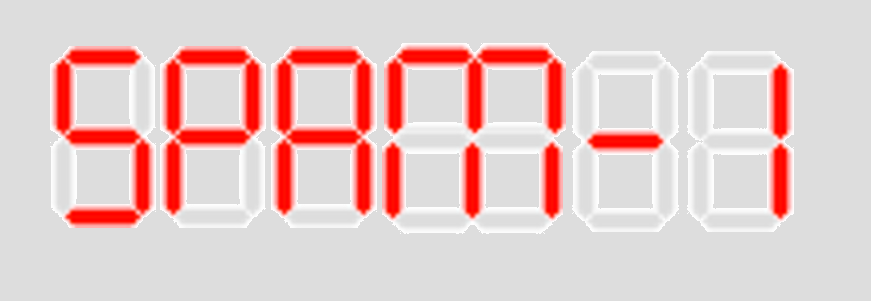
[picture p51: figure]

https://www.dcode.fr/7-segment-display
