Johnlon/spam-1/docs/SimpleCpu-blocks.pptx

3 phase clock:
INITIAL / RESET STATE:
phase == FETCH therefore AddressMode=PC, reset PC=0 , clock low
+ve edge DECODE PHASE:
LOAD IR AND ROM ADDR BUFFERS FROM ROM
Control logic settles including address mode.
Not FETCH therefore AddressMode=REGISTER OR IMMED as per IR
+ve edge EXEC PHASE :
LATCH ALU RESULT IN TARGET
Non overlapping clock means async components can latch safely at this moment
+ve edge FETCH PHASE:
ADVANCE PC UNLESS JUST LOADED IN EXEC PHASE
AddressMode=PC

Accept that I cannot index the ROM and RAM usefully in any way at same time without a separate address bus for RAM and ROM as both would access the address bus at same time.
So can’t use dev(RAM[MAR])=ROM[IMMED] for example

ALU Result Bus

Optional : PC Buffer L
Permits PC arithmetic
and storage. Is there any
case for this?

BUFFER I
_en

CONTROL LOGIC

UART Buffer isolation needed to prevent writes and reads from UART on one bus leaking over to the other bus.
Buffer I _oe = wr
Buffer L _oe = _rd
(wr is +ve edge latch)

BUFFER L
_en

wr
_rd

UART

_txe
_rxf

D

Optional : Flags reg on L Bus means we can store it
to RAM or to another reg and do arbitrary bitwise comparisons on the result.
Optional: But if we also allow it to be restored from RAM or a REG or ROM then that
might be extra useful – eg to set or clear carry before arithmetic.
Or is Carry a special case? Perhaps on a sophisticated CPU
stashing the flags might be useful, but here?

ALU L Bus

RAM isolation from result bus to avoid read / write or RAM leaking between Result Bus and R Bus.
Buffer I _oe = _wr
Buffer R _oe = _RAM _oe

L

BUFFER I
_en

BUFFER L
_en

BUFFER L
_en

BUFFER L
_en

BUFFER L
_en

TBD: Flags Reg
write _en may only be enabled for specific ops

FLAGS

BUFFER L
_en`

Attach RAM /ROM to
R Bus so they can
participate in ALU
as other side from
the other registers
Or UART.

Address Bus (A/16)

A/16

_oe

D[23:16]

A[15:0]

D[15:0]

ROM

CONTROL LOGIC

A/16

A[15:0]

_oe
_wr

PCHITmp

_en

D

Q

count_en
_pe

PCHI

D

count_en
_pe

D

CP

PCLO

MARHI

_en

D

MARLO

_en

D

Register file is a general
purpose register set

CP

rdL_addr
rdR_addr
wr_addr
_rdL_en
_rdR_en
_wr_en

`D

_MR

SYNC
REG FILE

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
_cin

ALU

D[15:8]

BUFFER AH
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
MAR primary function is Address Bus index.
Optionally MAR can join either/both L Bus
or R Bus depending
on flexibility desired.
So MAR also acts as a GP register on both ALUinput busses.

CP

Q

BUFFER AH
_en

CP

Q

BUFFER AL
_en

R

Optional extras: a presettable autocounting MAR?

CONTROL LOGIC

Result

D[7:0]

BUFFER R
_en

BUFFER R
_en

PCHI/LO Primary function is Address Bus index.
Optionally PC can join either/both L Bus or R Bus depending on whether I want to permit PC arithmetic.
Here PC is shown outputting to
L Bus.

BUFFER R
_en

BUFFER R
_en

CONTROL LOGIC

aluop

C
Z
O
GT
LT
EQ
NE

ALU R Bus

BUFFER AL
_en

R

D[7:0]

BUFFER AH
_en

BUFFER AL
_en

Address Bus Hi / 8

ROM BUFFER AH/L _en = NOT FETCH_PHASE & IMMED
MAR_BUFFER AH/L _en = NOT FETCH_PHASE & NOT IMMED
PC BUFFER AH/L _en = FETCH_PHASE

Address Bus Lo / 8

_we = LATCH @ END OF FETCH PHASE
WILL NEED TWO TRISTATE REGISTERS FOR THIS ROM ADDRESS BUS INTERFACE AND ALSO AN INSTRUCTION REGISTER FOR THE TOP BYTE INSIDE THE CONTROL LOGIC.
These registers/buffers and the top byte IR will always latch the ROM [23:0] at the end of the FETCH_PHASE so no separate control signal needed.

## Slide 2

ALU Result Bus

BUFFER I
_en

CONTROL LOGIC

BUFFER L
_en

wr
_rd

UART

_txe
_rxf

D

ALU L Bus

L

BUFFER I
_en

TBD: Flags Reg
write _en may only be enabled for specific ops

FLAGS

Address Bus (A/16)

A/16

_oe

D[23:16]

A[15:0]

D[15:0]

ROM

CONTROL LOGIC

A/16

A[15:0]

_oe
_wr

PCHITmp

_en

D

Q

count_en
_pe

PCHI

D

count_en
_pe

D

CP

PCLO

MARHI

_en

D

MARLO

_en

D

CP

rdL_addr
rdR_addr
wr_addr
_rdL_en
_rdR_en
_wr_en

`D

_MR

SYNC
REG FILE

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
_cin

ALU

D[15:8]

BUFFER AH
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
BUFFER AH
_en

CP

Q

R

CONTROL LOGIC

Result

D[7:0]

BUFFER R
_en

BUFFER R
_en

CONTROL LOGIC

aluop

C
Z
O
GT
LT
EQ
NE

ALU R Bus

BUFFER AL
_en

R

D[7:0]

BUFFER AH
_en

BUFFER AL
_en

BUFFER AL
_en

Address Bus Hi / 8

Address Bus Lo / 8

## Slide 3

ALU Result Bus

Attach RAM /ROM to
R Bus so they can
participate in ALU
as other side from
the other registers
Or UART.

A/16

_oe

D[23:16]

A[15:0]

D[15:0]

ROM

CONTROL LOGIC

BUFFER AH
_en

D[7:0]

BUFFER R
_en

BUFFER AL
_en

Address Bus (A/16)

D[7:0]

?? If these were tristate registers then would this avoid the need for a distinct IR as these would latch the address from the ROM moments before being applied as the address to the ROM

? extra _we ?

D[15:8]

BUFFER L
_en

BUFFER L
_en

PCHITmp

CP

D

_en

Q

count_en
_pe

CP

D

PCHI

_MR

count_en
_pe

CP

D

PCLO

_MR

Q

Q

PCHI/LO Primary function is Address Bus index.
Optionally PC can join either/both L Bus or R Bus depending on whether I want to permit PC arithmetic.
Here PC is shown outputting to
L Bus.

BUFFER AH
_en

BUFFER AL
_en

BUFFER L
_en

BUFFER L
_en

MARHI

CP

D

_en

MARLO

CP

D

_en

MAR primary function is Address Bus index.
Optionally MAR can join either/both L Bus
or R Bus depending
on flexibility desired.
So MAR also acts as a GP register on both ALUinput busses.

Q

BUFFER AH
_en

Q

BUFFER AL
_en

BUFFER R
_en

BUFFER R
_en

RAM isolation from result bus to avoid read / write or RAM leaking between Result Bus and R Bus.
Buffer I _oe = _wr
Buffer R _oe = _RAM _oe

BUFFER I
_en

A/16

_wr
_oe

A[15:0]

RAM

wr
_rd

D

BUFFER R
_en

BUFFER I
_en

CONTROL LOGIC

UART Buffer isolation needed to prevent writes and reads from UART on one bus leaking over to the other bus.
Buffer I _oe = wr
Buffer L _oe = _rd
(wr is +ve edge latch)

BUFFER L
_en

_txe
_rxf

D

UART

Optional : Flags reg on L Bus means we can store it
to RAM or to another reg and do arbitrary bitwise comparisons on the result.
Optional: But if we also allow it to be restored from RAM or a REG or ROM then that
might be extra useful – eg to set or clear carry before arithmetic.
Or is Carry a special case? Perhaps on a sophisticated CPU
stashing the flags might be useful, but here?

ALU L Bus

L

TBD: Flags Reg
write _en may only be enabled for specific ops

FLAGS

BUFFER L
_en`

Register file is a general
purpose register set

rdL_addr
rdR_addr
wr_addr
_rdL_en
_rdR_en
_wr_en

CP

D

_MR

SYNC
REG FILE

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
_cin

ALU

R

CONTROL LOGIC

Result

C
Z
O
GT
LT
EQ
NE

ALU R Bus

R

Address Bus Hi / 8

Optional extras: a presettable autocounting MAR?

Address Bus Lo / 8

## Slide 4

ALU Result Bus

Optional : Flags reg on L Bus means we can store it
to RAM or to another reg and do arbitrary bitwise comparisons on the result.
Optional: But if we also allow it to be restored from RAM or a REG or ROM then that
might be extra useful – eg to set or clear carry before arithmetic.
Or is Carry a special case? Perhaps on a sophisticated CPU
stashing the flags might be useful, but here?

ALU L Bus

RAM isolation from result bus to avoid read / write or RAM leaking between Result Bus and R Bus.
Buffer I _oe = _wr
Buffer R _oe = _RAM _oe

L

BUFFER I
_en

BUFFER I
_en

CONTROL LOGIC

UART Buffer isolation needed to prevent writes and reads from UART on one bus leaking over to the other bus.
Buffer I _oe = wr
Buffer L _oe = _rd
(wr is +ve edge latch)

BUFFER L
_en

BUFFER L
_en

BUFFER L
_en

BUFFER L
_en

BUFFER L
_en

TBD: Flags Reg
write _en may only be enabled for specific ops

FLAGS

BUFFER L
_en`

Attach RAM /ROM to
R Bus so they can
participate in ALU
as other side from
the other registers
Or UART.

Address Bus (A/16)

A/16

_oe

D[23:16]

A[15:0]

D[15:0]

ROM

CONTROL LOGIC

A/16

_wr
_oe

A[15:0]

wr
_rd

UART

PCHITmp

CP

D

_en

Q

count_en
_pe

CP

D

PCHI

_MR

count_en
_pe

CP

D

PCLO

_MR

MARHI

CP

D

_en

MARLO

CP

D

_en

Register file is a general
purpose register set

rdL_addr
rdR_addr
wr_addr
_rdL_en
_rdR_en
_wr_en

CP

D

_MR

SYNC
REG FILE

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
_cin

ALU

D[15:8]

BUFFER AH
_en

RAM

D

_txe
_rxf

D

Q

Q

MAR primary function is Address Bus index.
Optionally MAR can join either/both L Bus
or R Bus depending
on flexibility desired.
So MAR also acts as a GP register on both ALUinput busses.

Q

BUFFER AH
_en

Q

BUFFER AL
_en

R

Optional extras: a presettable autocounting MAR?

CONTROL LOGIC

Result

D[7:0]

BUFFER R
_en

BUFFER R
_en

PCHI/LO Primary function is Address Bus index.
Optionally PC can join either/both L Bus or R Bus depending on whether I want to permit PC arithmetic.
Here PC is shown outputting to
L Bus.

BUFFER R
_en

BUFFER R
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
ALU R Bus

BUFFER AL
_en

R

D[7:0]

BUFFER AH
_en

BUFFER AL
_en

Address Bus Hi / 8

Address Bus Lo / 8
