Johnlon/spam-1/docs/alu_external_logic.png

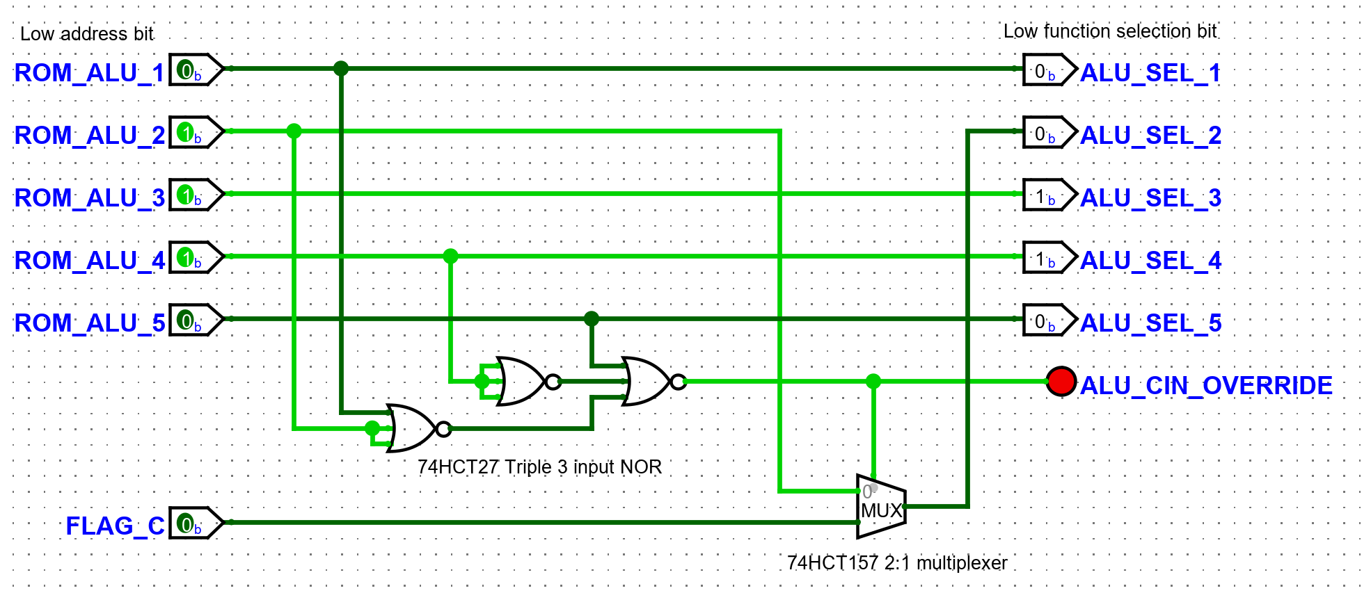
docs/alu_external_logic.png
