Johnlon/spam-1/docs/blocks.png

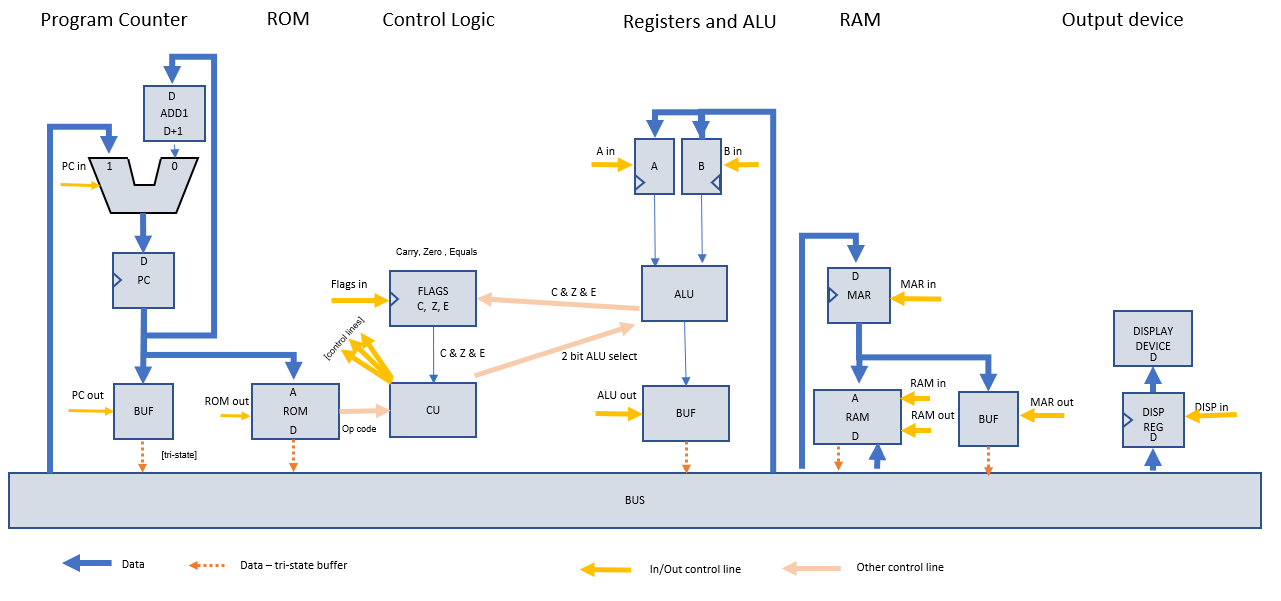
docs/blocks.png
