Johnlon/spam-1/docs/cpu-verilog.png

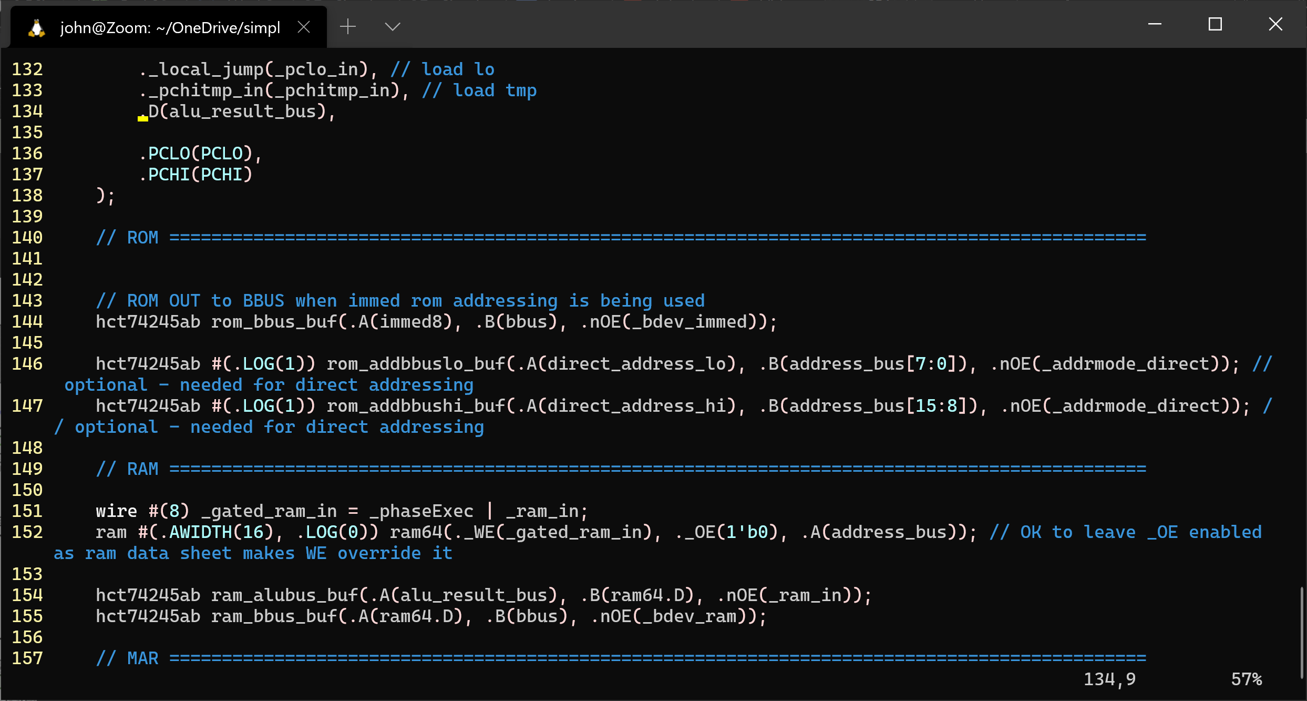
docs/cpu-verilog.png
