Johnlon/spam-1/docs/cpu.png

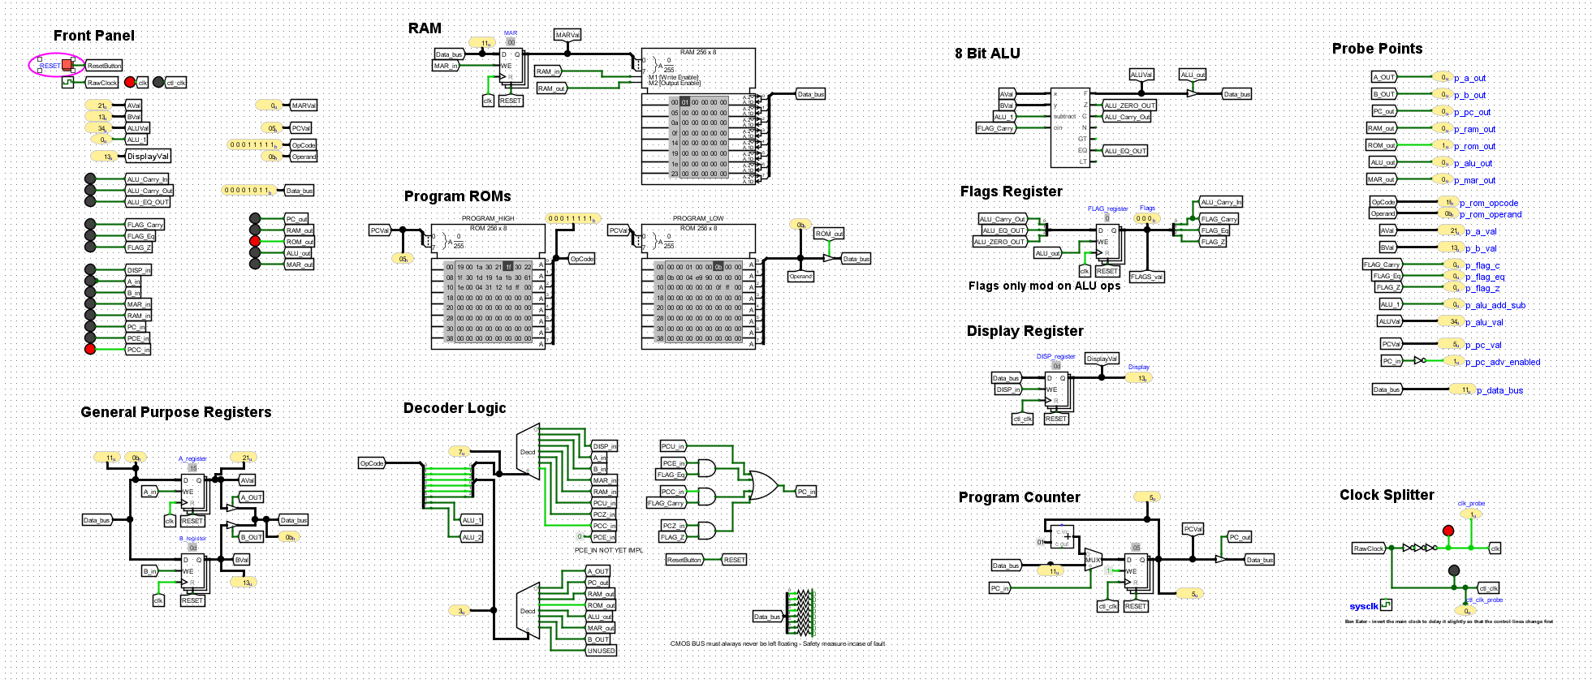
docs/cpu.png
