Johnlon/spam-1/docs/d6.jpg

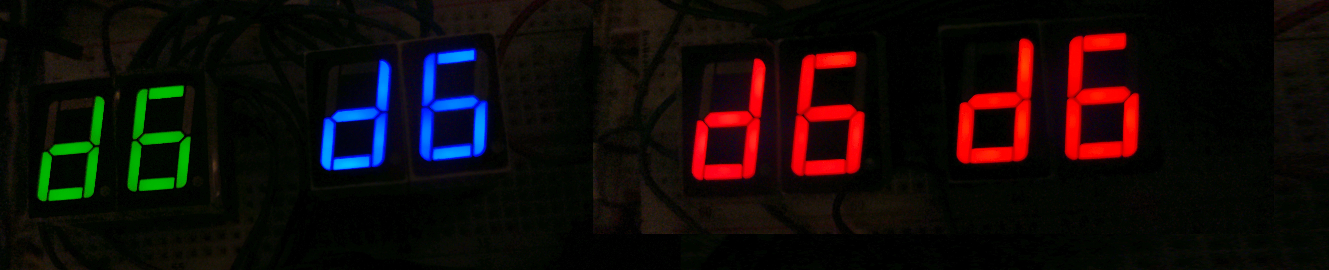
docs/d6.jpg
