Johnlon/spam-1/docs/decoder.png

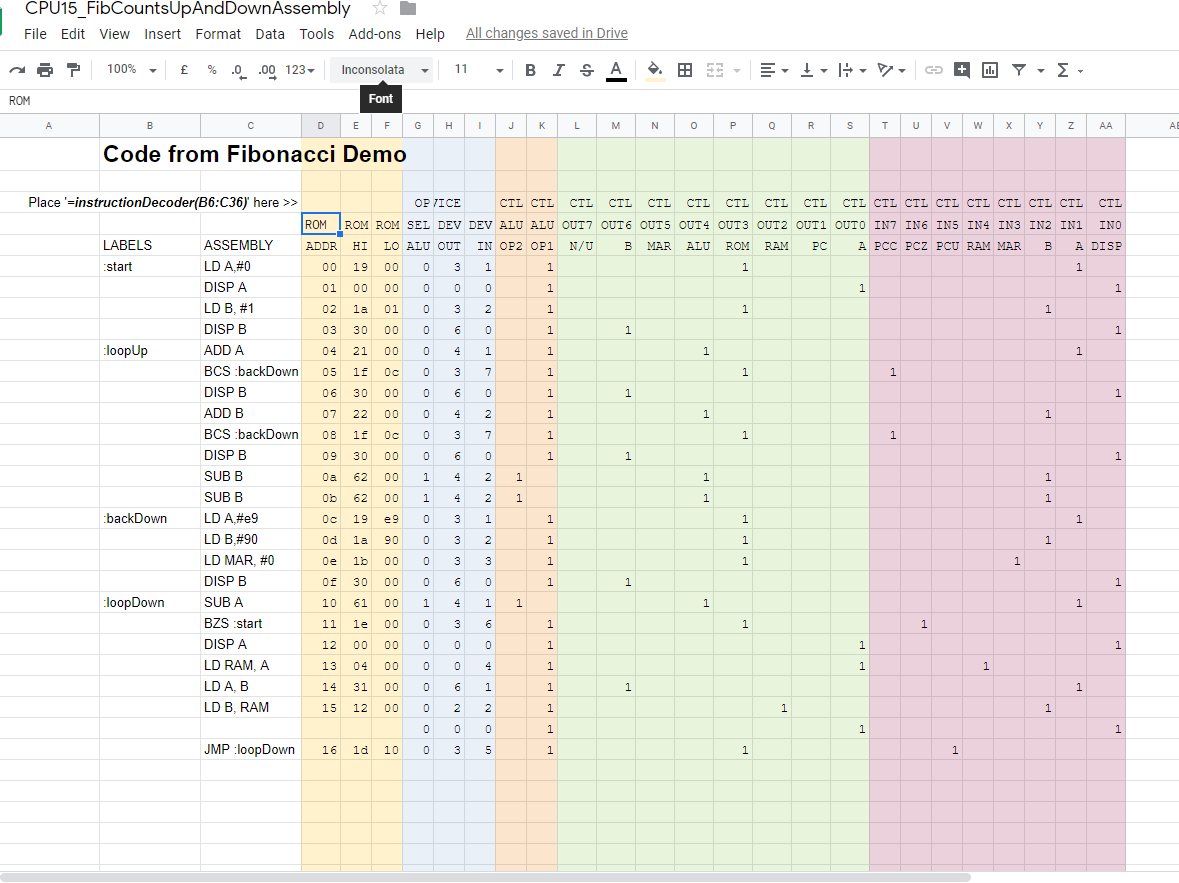
docs/decoder.png
