Johnlon/spam-1/docs/draft-v3-block-diagram.png

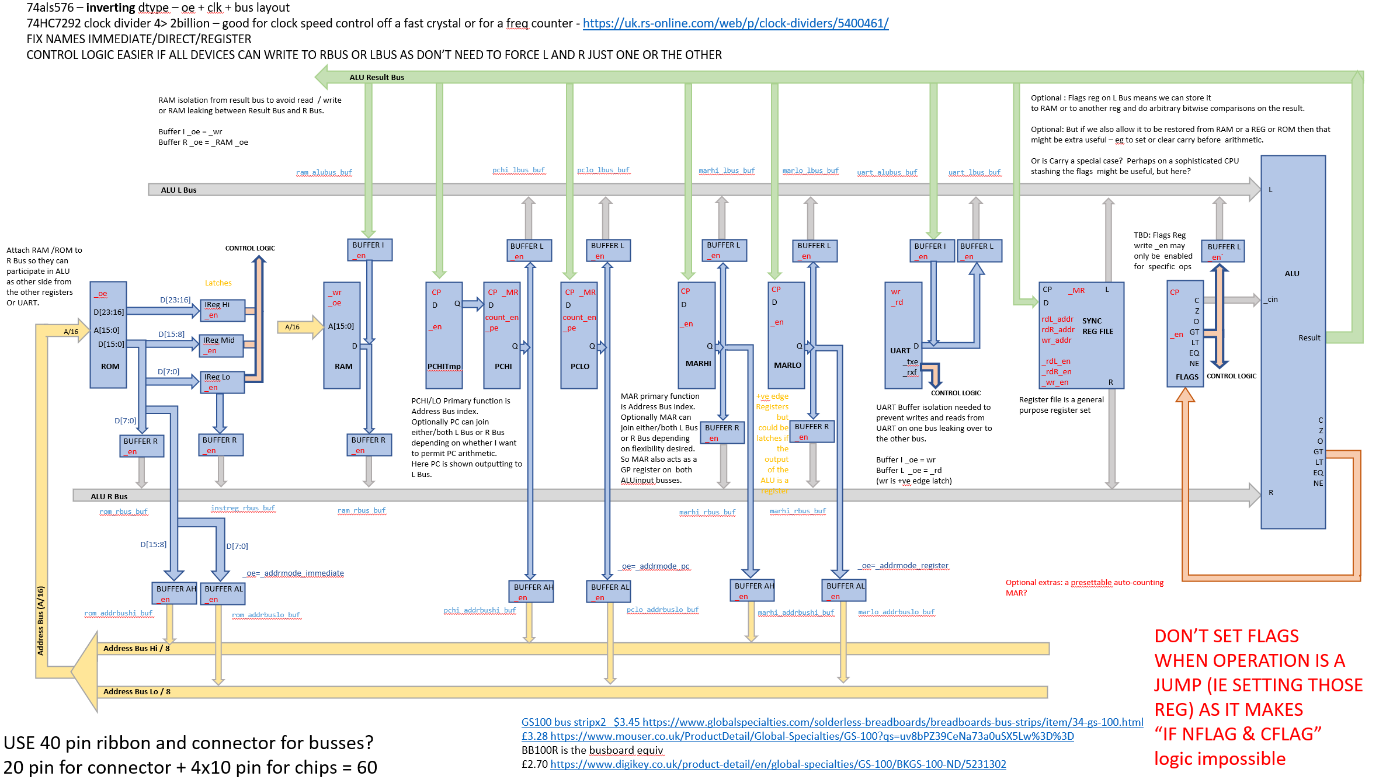
docs/draft-v3-block-diagram.png
