Johnlon/spam-1/docs/first-cut-all-via-alu.png

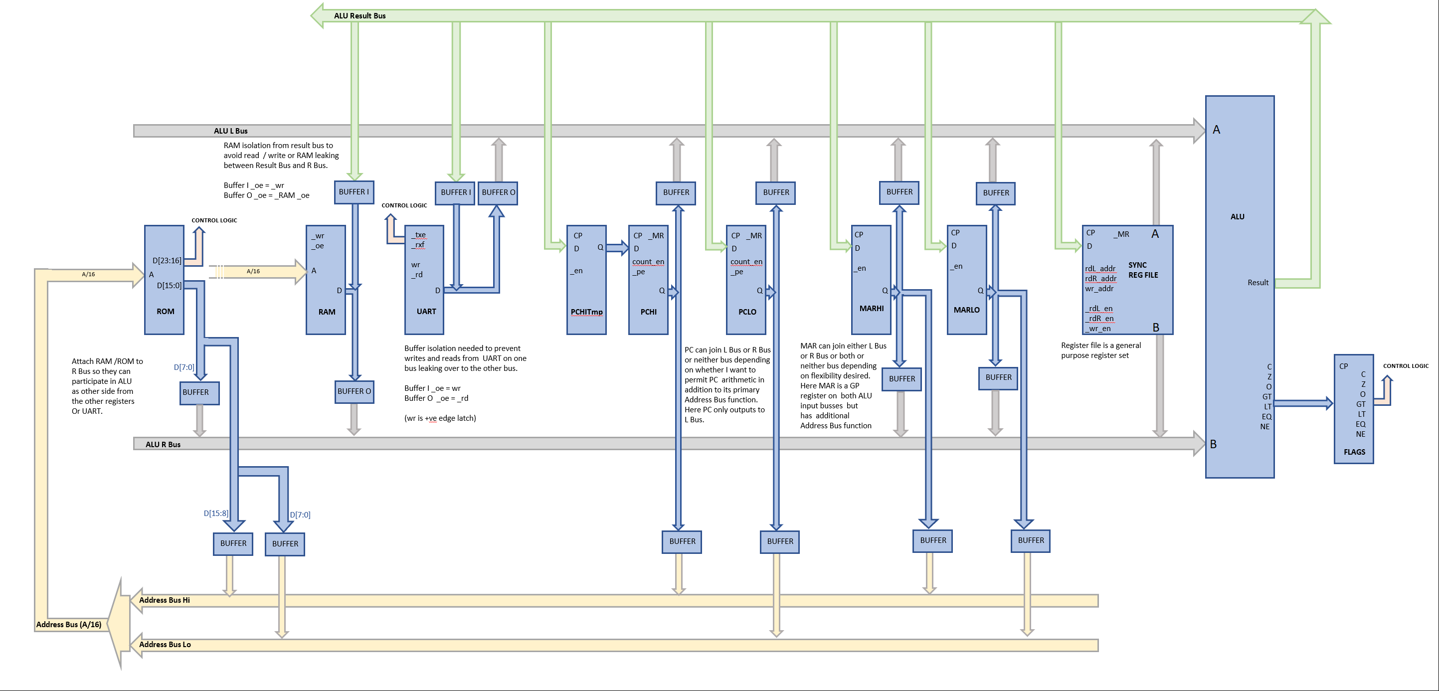
docs/first-cut-all-via-alu.png
