Johnlon/spam-1/docs/layout-breadboard-chips.jpg

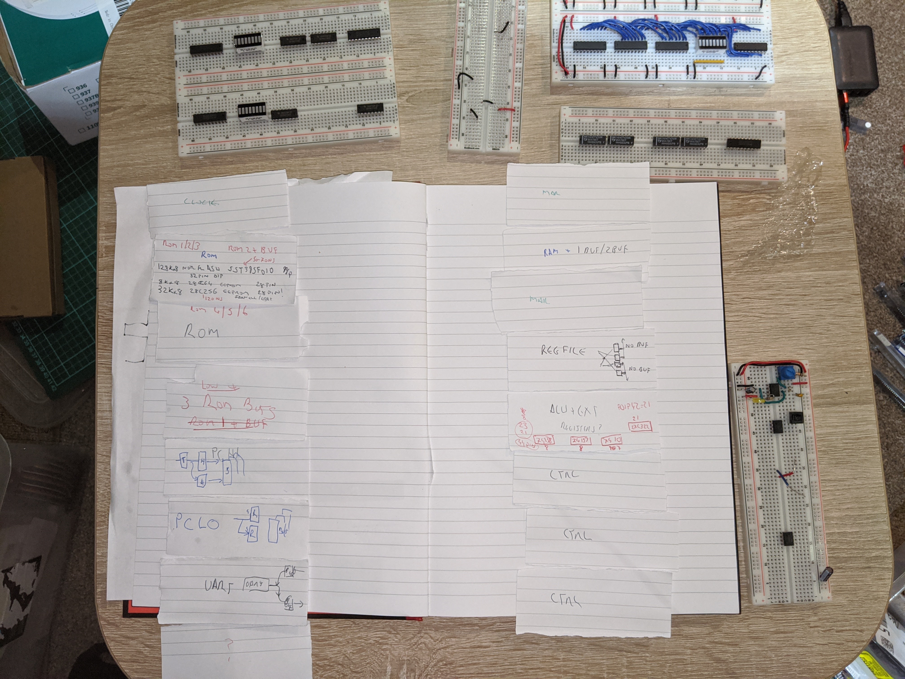
docs/layout-breadboard-chips.jpg
