Johnlon/spam-1/docs/MAR_BREADBOARD _IDEA1.png

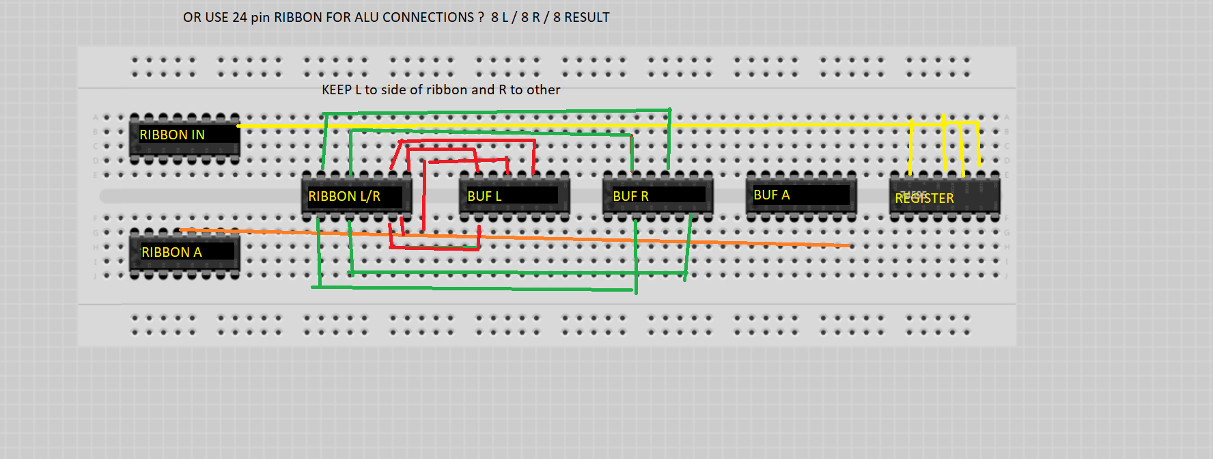
docs/MAR_BREADBOARD _IDEA1.png
