Johnlon/spam-1/docs/MAR_BREADBOARD _IDEA.png

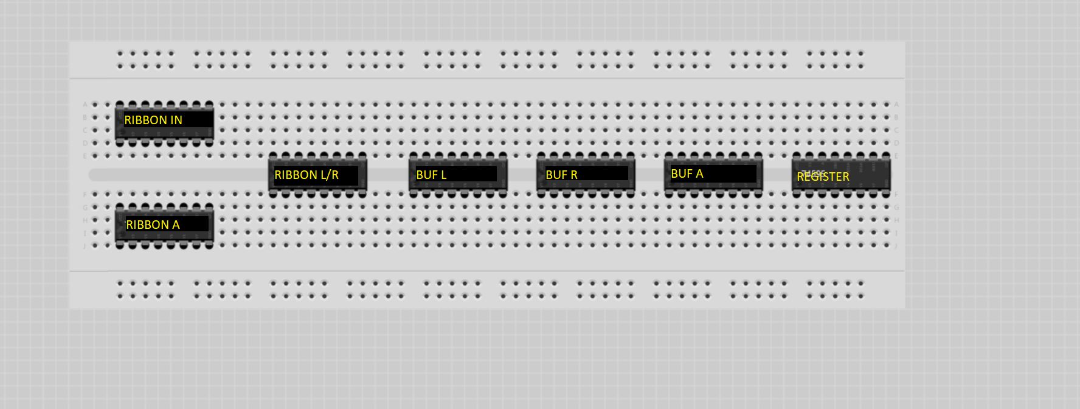
docs/MAR_BREADBOARD _IDEA.png
