Johnlon/spam-1/docs/misc/um245-thumb.jpg

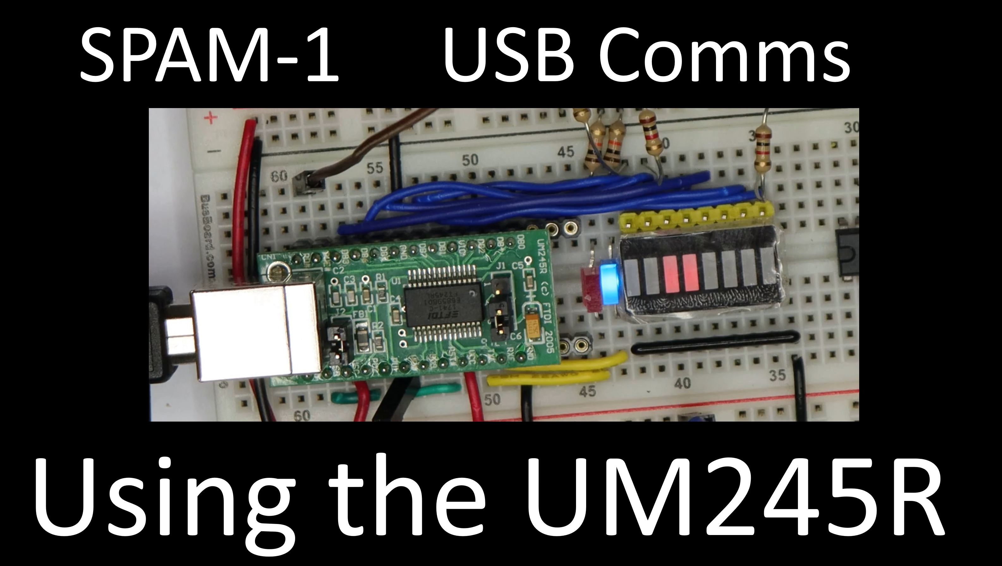
docs/misc/um245-thumb.jpg
