Johnlon/spam-1/docs/pc-hardware.jpg

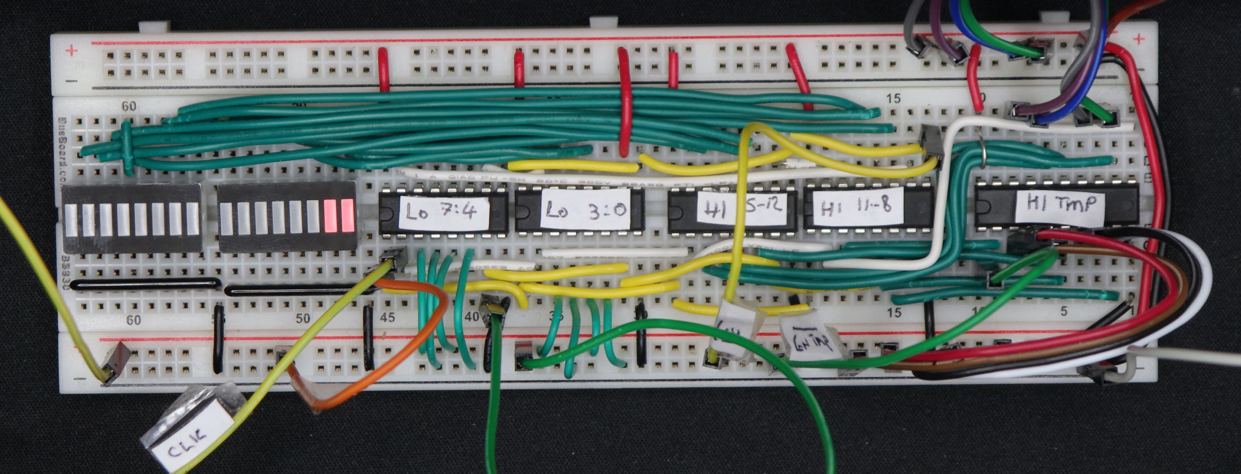
docs/pc-hardware.jpg
