Johnlon/spam-1/docs/pc_using_counter.png

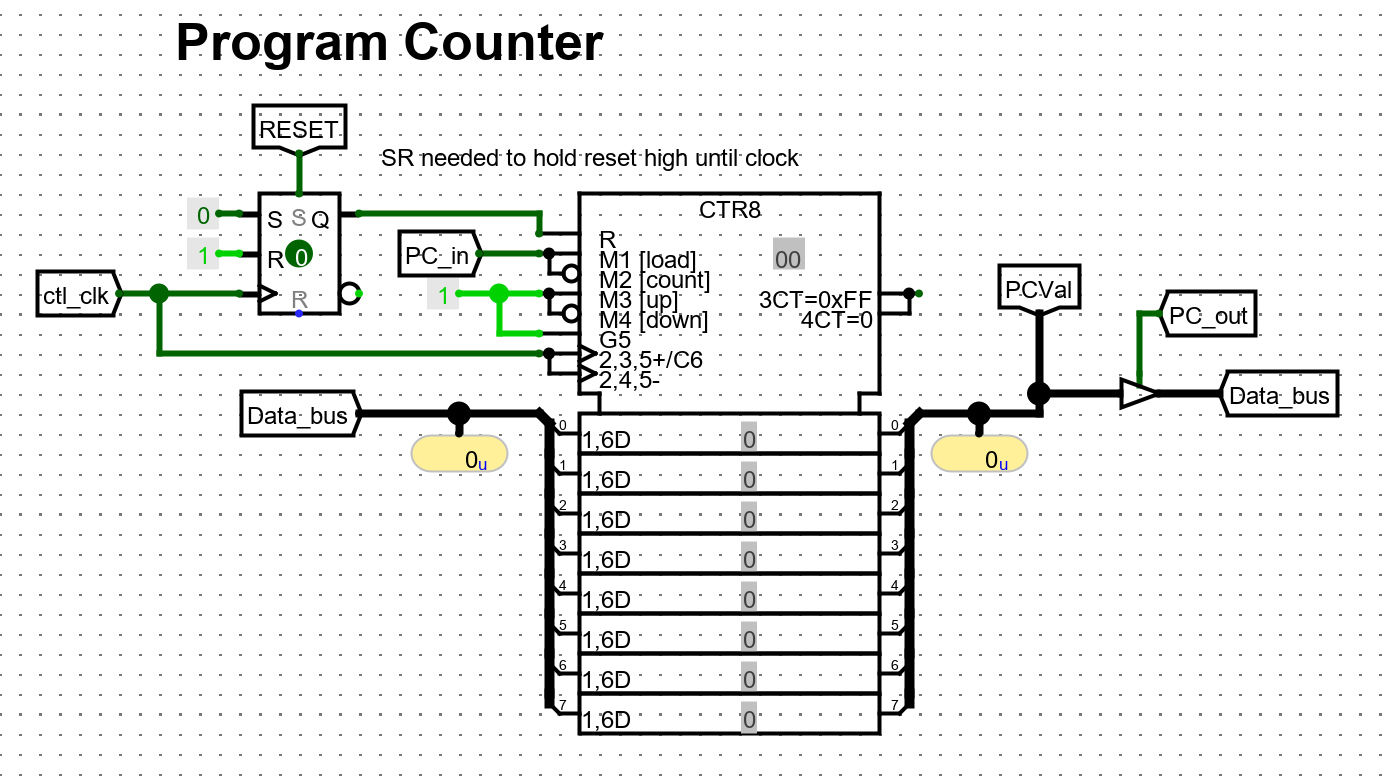
docs/pc_using_counter.png
