Johnlon/spam-1/docs/pc_using_latch_and_adder.png

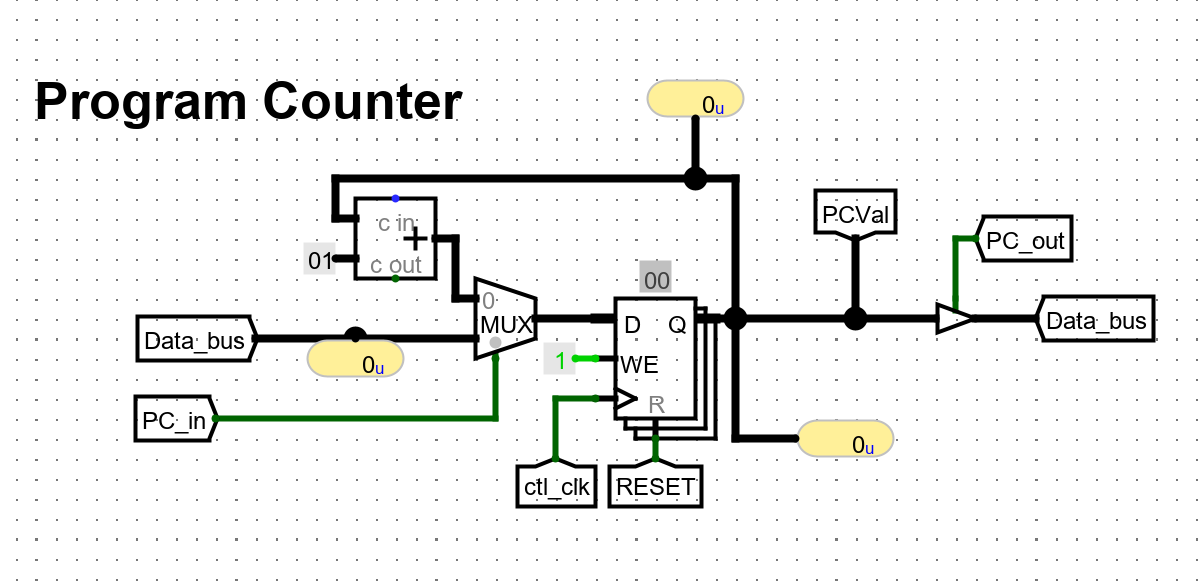
docs/pc_using_latch_and_adder.png
