Johnlon/spam-1/docs/s16.bmp

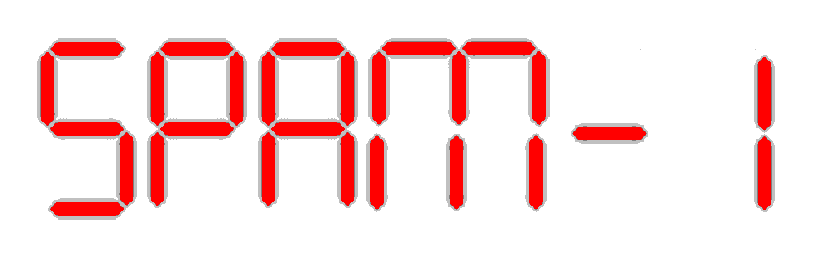
docs/s16.bmp
