Johnlon/spam-1/docs/s16crop.png

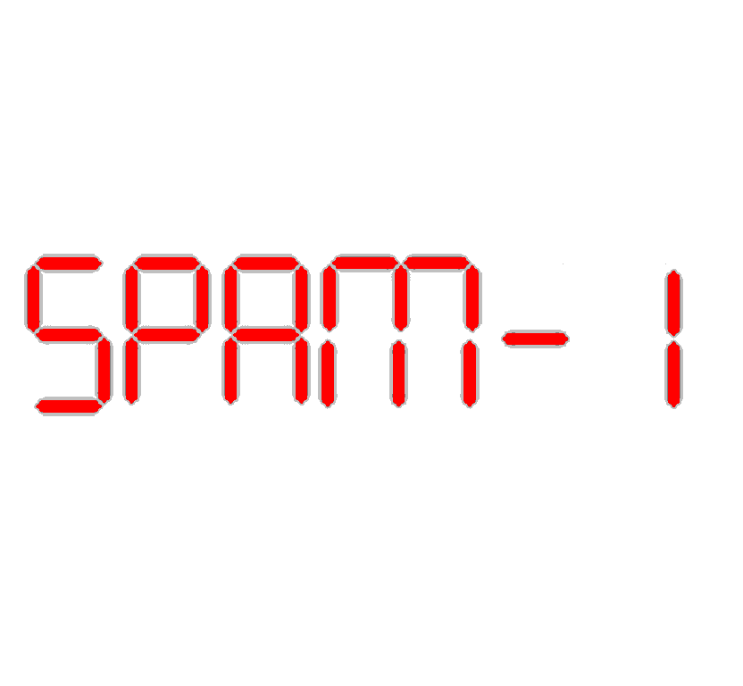
docs/s16crop.png
