Johnlon/spam-1/docs/s.png

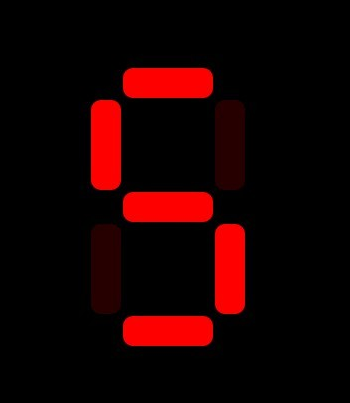
docs/s.png
