Johnlon/spam-1/docs/thumbnail1.png

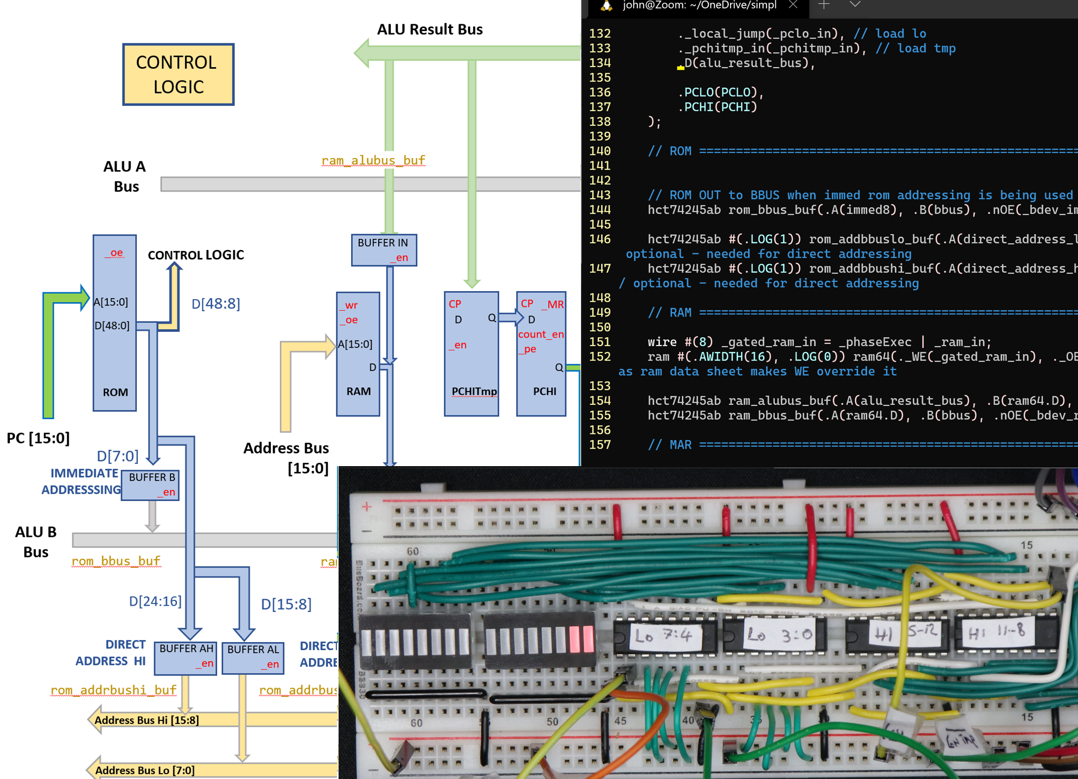
docs/thumbnail1.png
