Johnlon/spam-1/docs/thumbnail.png

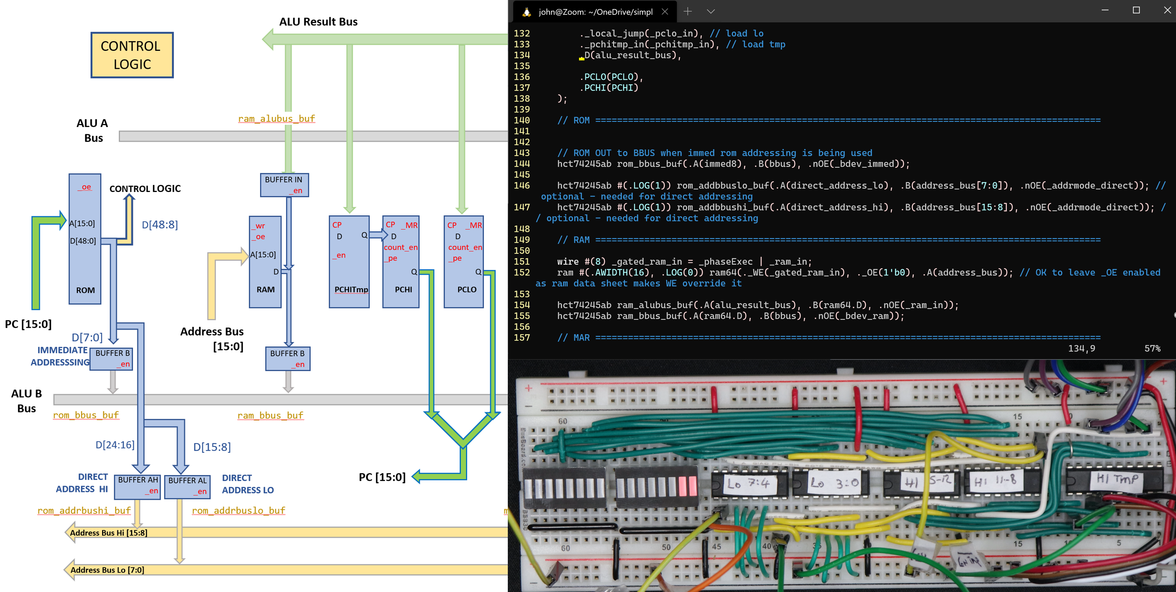
docs/thumbnail.png
