Johnlon/spam-1/docs/timing-honest.png

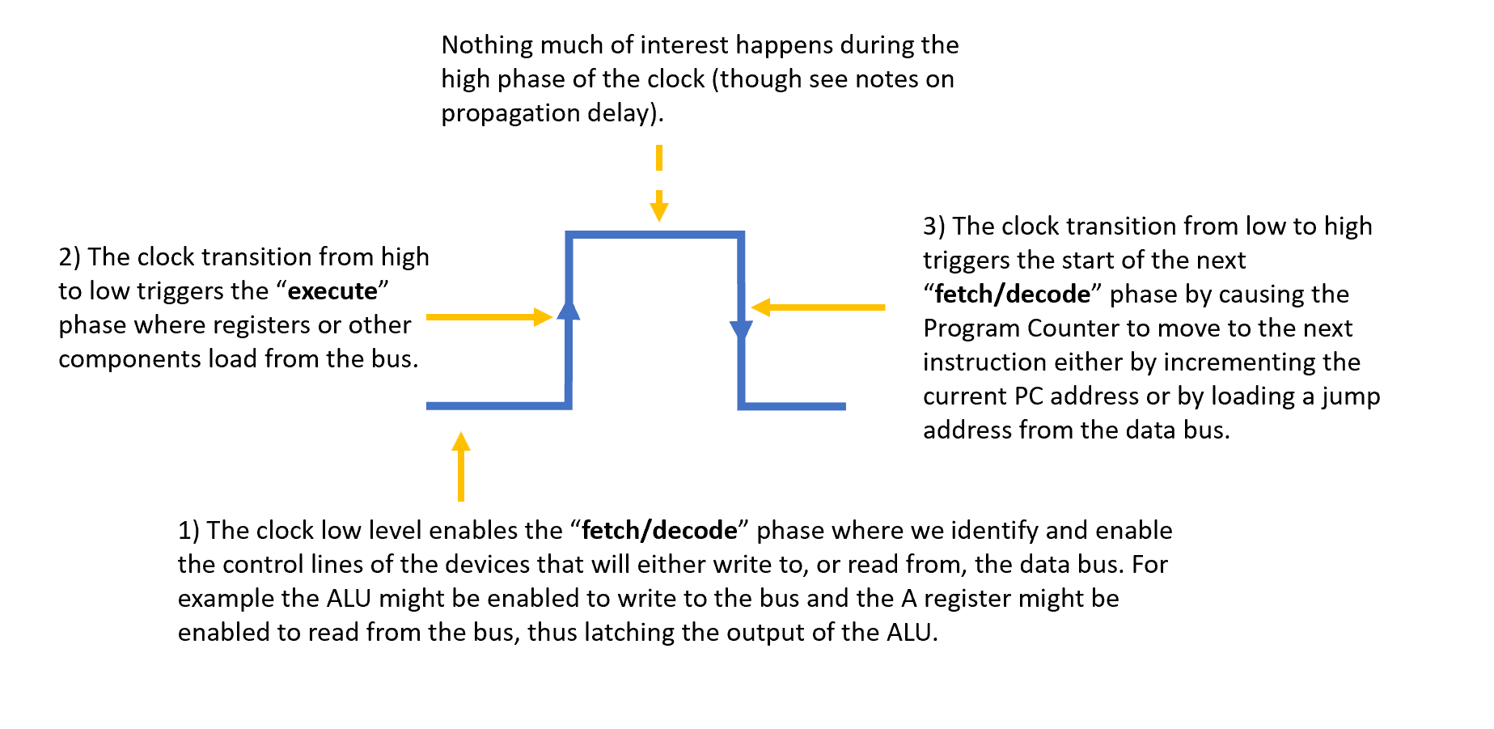
docs/timing-honest.png
