Johnlon/spam-1/docs/vscode-extensions.bmp

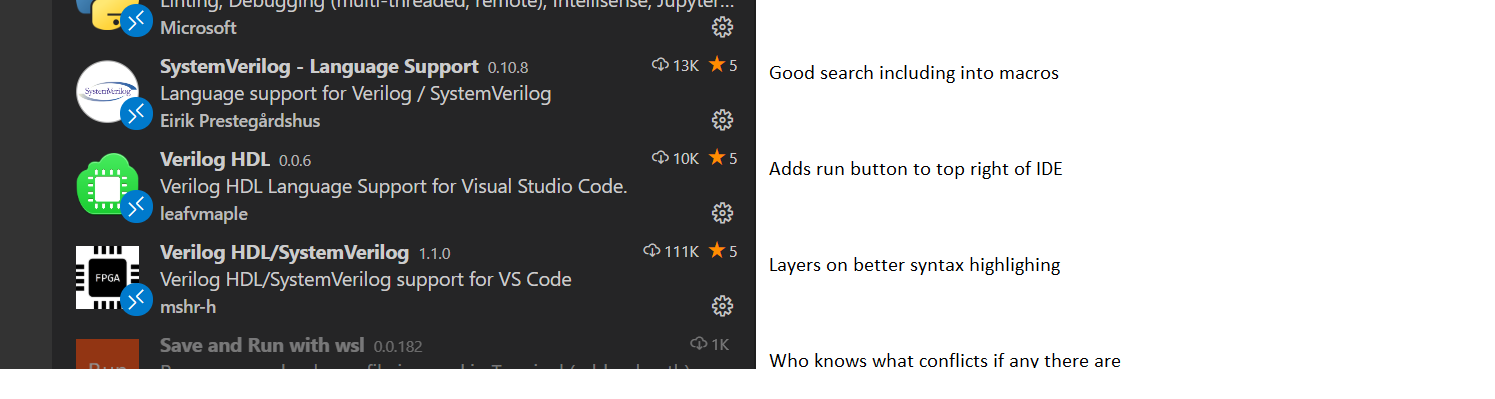
docs/vscode-extensions.bmp
