Johnlon/spam-1/docs/Component block diagram.pptx

Address HI Path

/8

ALU

A

out

/8

PCHITMP

/8

PCHI

/16

Program Counter Address Bus

/8

B

/8

/8

PCLO

Address Lo Path

/8

PCHI

PCLO

/16

PC Address Bus

/8

## Slide 2

TRIPLE PORT REGISTER FILE 4 x 8 BIT

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
74HCT670
A : LO 4 Bits

74HCT670
A : HI 4 Bits

RA_ADDR[1:0]

D[3:0]

Q

QA[7:0]

W_ADDR[1:0]

Q

D[7:4]

D[7:0]

74HCT670
B : HI 4 Bits

74HCT670
B : LO 4 Bits

D[3:0]

Q

QB[7:0]

Q

RB_ADDR[1:0]

## Slide 3

Input Port

/8

TRIPLE PORT REGISTER FILE
4 x 8 BIT

Register 0

Register 1

Register 2

Register 3

/8

/8

Output Port A

Output Port B

/Write Enable

Write Register Select

/1

/2

/2

/2

Output Port A Register Select

Output Port B Register Select

W_ADDR[1:0]

RB_ADDR[1:0]

RA_ADDR[1:0]

W_ADDR[1:0]

4 x 8 BIT

TRIPLE PORT REGISTER FILE

D[7:0]

QA[7:0]

QB[7:0]

## Slide 4

t0: VALUE = X + 1
t1: VALUE = X + 1 + 1

t0: VALUE = X
t1: VALUE = X +1

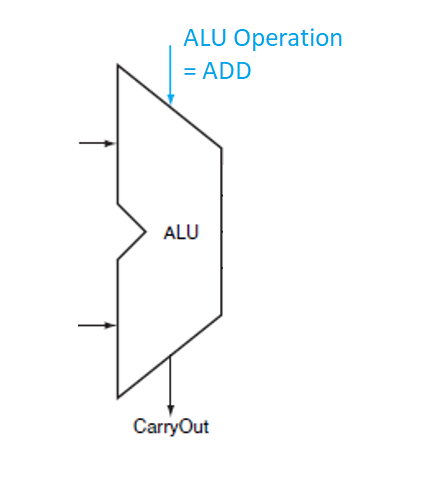
[picture p79: figure]

ASYNCHRONOUS
REGISTER
FILE

READ ADDR = 0
WRITE ADDR = 0

/WE

VALUE = 1

## Slide 5

t0: VALUE = X + 1
t1: VALUE = X + 1 + 1

t0: VALUE = X
t1: VALUE = X +1

8 BIT
NEGATIVE EDGE TRIGGERED
D TYPE FLIP-FLOP

ASYNCHRONOUS
REGISTER
FILE

READ ADDR = 0
WRITE ADDR = 0

CLOCK

/WE

VALUE = 1

## Slide 6

RA

8 bit flipflop

Addr=1

CP or LE

/OE

Write address decoding logic is needed!

Write addr logic!

QA

Addr=0

8 bit flipflop

RB

D

8 bit flipflop

Addr=1

Write addr logic!

Write addr logic!

QB

Addr=0

8 bit flipflop

Any 8 bit register with a tristate outputs can be directly multiplexed onto dual output busses.
Decoding is needed to select which register has it’s output enabled.
A 2 slot register file can decode using a invertor,
but for more registers use a 74139 or 74138.
74374/74574 are edge triggered and will need to gate a write control line with a clock signal to control which address gets written to.
74373/74573 are level sensitive latches and will need external logic to control which register gets updates, but may also need some extra help to work well in a synchronous circuit

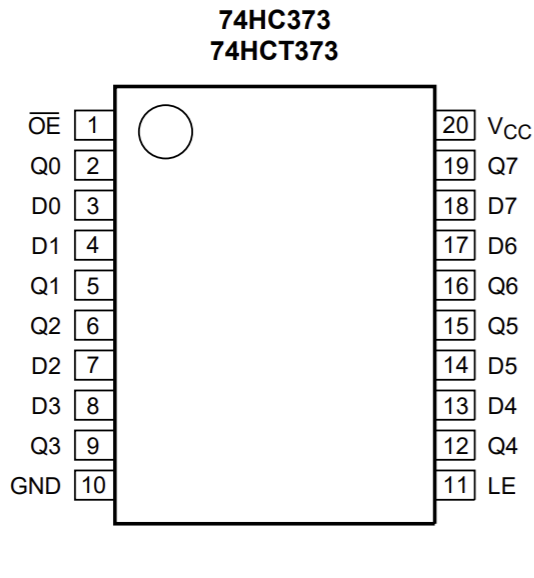
[picture p80: figure]
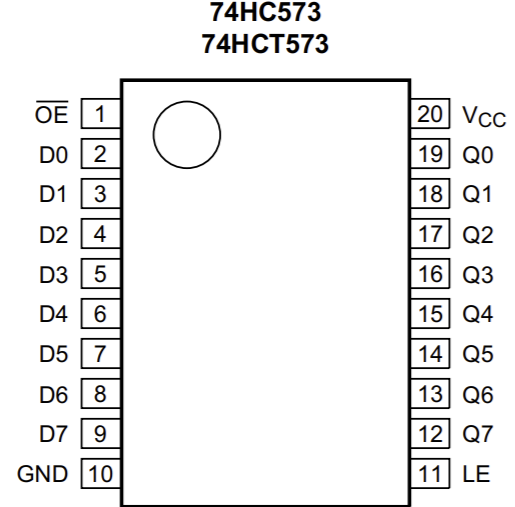
[picture p81: figure]
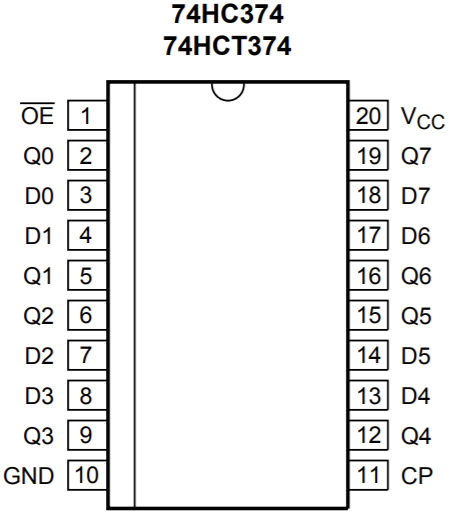
[picture p82: figure]
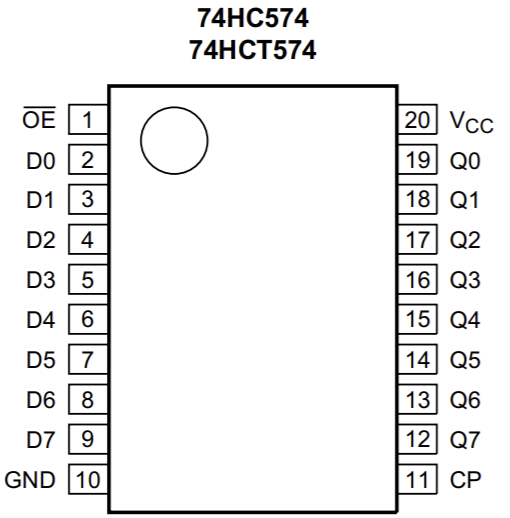
[picture p83: figure]

## Slide 7

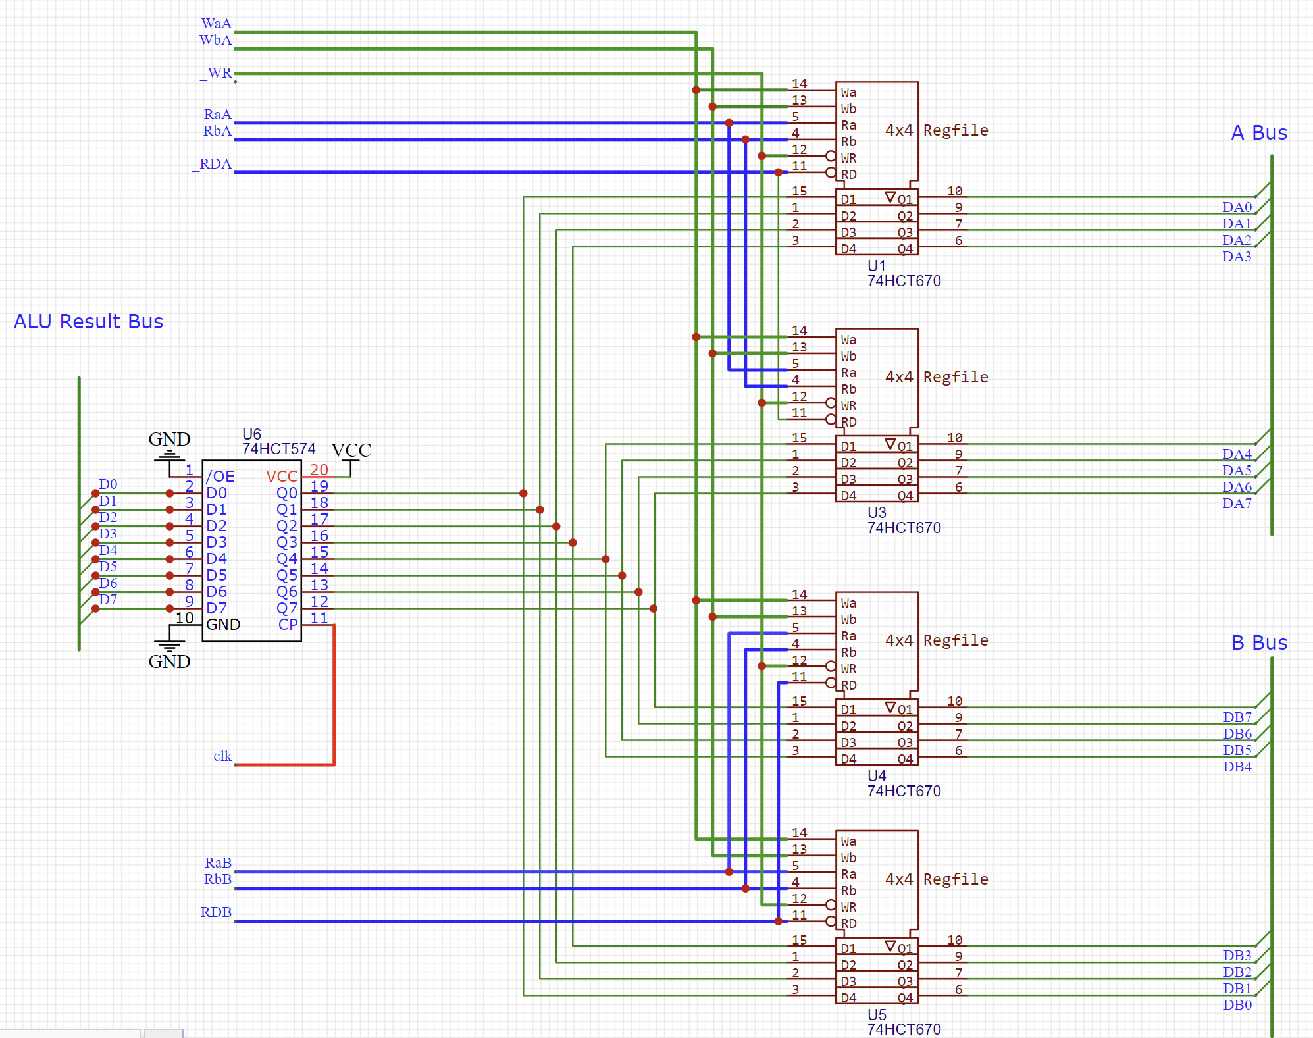
[picture p84: figure]
Machine generated alternative text: WbA WR RbA RDA iiii—— ALU 14 13 Wb 12 WR 11 RD 15 4x4 Regfile 10 74HCT670 Result Bus GND DO DO DI 10 GND GND clk RaB RbB RDB iiiiiiiiiiiiiiiiiiiiiii. I-J6 74HCT574 VCC 20 vcc 19 17 Q6 12 11 iiiäiäiäiäi 14 Wb 12 WR 11 15 Wb WR 15 D4 14 13 Wb 12 WR 11 RD 15 4x4 IJ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

## Slide 8

This pattern is useful where the register type doesn’t have tristate outputs…

Triple Port Register Patterns Using Dual Port Components

A: register read select

/2

Decode logic

OE

Register write select

CLK

Decode logic

74245

74273

74273

74273

/2

/8

74245

74245

/8

A

74245

Data In

/8

74377 has CLK and EN for decode
74273 has CLK and MR for initialization
74163 is a counter register

B: register read select

74273

/8

74245

74245

74245

/8

B

74245

Decode logic

/2

## Slide 9

Triple Port Register Patterns Using Dual Port Components

This pattern is useful where the register type doesn’t have tristate outputs…

74377 has CLK and EN for decode
74273 has CLK and MR for initialization
74163 is a counter register

B: register read select

A: register read select

/2

Decode logic

OE

Register write select

CLK

Decode logic

74245

74273

74273

74273

/2

/8

74245

74245

/8

A

74245

Data In

/8

74273

/8

74245

74245

74245

/8

B

74245

Decode logic

OE

/2

Use this more direct approach if your device does have tristate outputs.
This approach combined with a decoder chip is more convenient

Eg collection of 74574 with their CP input being driven by a 74138 decoder, where the 74138 enabled input is hooked up to the system clock is a more convenient approach

B: register read select

A: register read select

/2

Decode logic

OE

Register write select

CLK

/2

Decode logic

74574

/8

74574

74574

/8

A

74574

Data In

/8

/8

74574

74574

74574

/8

B

74574

Decode logic

OE

/2

## Slide 10

Triple Port Register Patterns Using Dual Port Components

Using a single register with two buffers is less efficient….

OE

Buf A

Buf B

Reg

QA

D

QB

## Slide 11

Triple Port Register Patterns Using Dual Port Components

Using a single register with two buffers is less efficient….

.. than using a pair of tristate capable registers

OE

Buf A

OE

Reg A

Reg

QA

QA

D

Buf B

D

Reg B

QB

QB

For example these devices …

74374
Flipflop

74574
Flipflop
Bus Pinout

74373
Latch

74573
Latch
Bus Pinout

## Slide 12

OE

Buf A

OE

Reg A

QA

QA

D

Reg

D

Buf B

QB

Reg B

QB

Triple Port Register Patterns

OE

Buf A

Reg

LED

QA

D

Buf B

QB

## Slide 13

.. than using a pair of tristate capable registers

Using a single register with two buffers is less efficient….

OE

Buf A

OE

Reg A

Reg

QA

QA

D

Buf B

D

Reg B

QB

QB

However, using buffers is certainly handy for isolating LED indicators so that we can see what’s in the register …

For example these devices …

74374
Flipflop

74574
Flipflop
Bus Pinout

OE

Buf A

QA

D

Reg

LED

74373
Latch

74573
Latch
Bus Pinout

… any latch or flipflop or parallel output device such as counters work in this context.

Buf B

QB

## Slide 14

Triple Port Register Patterns Using Dual Port Components

OE

Reg A

Reg B

D

QA

OE

QB

## Slide 15

Triple Port Register Patterns Using Dual Port Components

LE/CP

OE

OE

Reg A[3]

QA

OE

Reg A

LE/CP

LE/CP

OE

Reg A[1]

Reg A[2]

D

QA

LE/CP

OE

Reg A[0]

OE

Reg B

QB

D

LE/CP

OE

Reg B[0]

Reg B[1]

LE/CP

LE/CP

OE

Reg B[1]

LE/CP

OE

OE

Reg B[1]

QB

## Slide 16

The above approach only pulses the selected 74138 output low during one half of the clock (use the appropriate 74138 “EN” input to choose the desired phase)
HAZARD: Do not rely on the address control lines alone to trigger the write signal of the registers. THAT APPROACH WILL LIKELY GLITCH!
Unless a device declares itself as glitch-free then you must assume that it will glitch during transitions.
ADVICE: assume that all switching devices will glitch during transitions and design to avoid the risk.

A

74138

OE A

Reg A[3]

QA READ ADDR

OE A

LE/CP

LE/CP

OE A

Reg A[2]

QA

Data input and Write address must settle before the active clock transition (flip flops) or active clock phase (latches).
If you are using latches rather than flip flips then additionally be careful that the write address control lines and the data input lines don’t shift again during the active phase of the clock

LE/CP

OE A

OE A

Reg A[0]

74574

Reg A[1]

WRITE ADDR

CLK

EN

A

74138

LE/CP

D

LE/CP

LE/CP

Reg B[0]

LE/CP

OE B

OE B

Reg B[1]

Reg B[1]

QB READ ADDR

A

74138

OE B

LE/CP

LE/CP

OE B

OE B

Reg B[1]

QB
