Johnlon/spam-1/docs/SPAM1-16-instruction-set.xlsx

Sheet: Sheet1
 | PCLOin | PCHIin | PCHItmp | REGin | MARLOin | MARHIin | UARTin | RAMin |  |  |  |  |  |  |  |  | UARTout | RAMout | ROMout | ALUout
 | BUS_WR |  |  |  | BUS_RD | Device read from bus
 | 0 | 0 | ROMout |  | 0 | 0 | 0 |  |  | noop
 | 0 | 1 | RAMout |  | 0 | 0 | 1 | REGin |  | write to a reg
 | 1 | 0 | UARTout |  | 0 | 1 | 0 | RAMin |  | write to ram
 | 1 | 1 | ALUout |  | 0 | 1 | 1 | PCHiIn |  | load hi jmp address
 |  |  |  |  | 1 | 0 | 0 | PCJmpIn |  | load lo and commit hi jmp
 |  |  |  |  | 1 | 0 | 1 | MARLOin |  | load lo ram
 |  |  |  |  | 1 | 1 | 0 | MARHIin |  | load hi ram
 |  |  |  |  | 1 | 1 | 1 | UARTin
Free bits for more registers??
 | 0 | 1 | 2 | 3 | 4 | 5 | 6 | 7 | 0 | 1 | 2 | 3 | 4 | 5 | 6 | 7 | 0 | 1 | 2 | 3 | 4 | 5 | 6 | 7
 | READ | READ | WRITE | WRITE | WRITE | WRITE | WRITE | x | OPER | OPER | OPER | OPER | OPER | OPER | OPER | OPER
load immed | ROM_out | ROM_out | REGin | REGin | REGin | REGin | REGin | x | DATA | DATA | DATA | DATA | DATA | DATA | DATA | DATA
load immed | ROM_out | ROM_out | RAMin | RAMin | RAMin | RAMin | RAMin | x | DATA | DATA | DATA | DATA | DATA | DATA | DATA | DATA
load immed | ROM_out | ROM_out | Xin | Xin | Xin | Xin | Xin | x | DATA | DATA | DATA | DATA | DATA | DATA | DATA | DATA
ram out[#0-127] | RAM_out | RAM_out | Xin | Xin | Xin | Xin | Xin | MAR=0 | x | x | x | x | x | x | x | x | x | ZPADDR | ZPADDR | ZPADDR | ZPADDR | ZPADDR | ZPADDR | ZPADDR
ram out[MAR] | RAM_out | RAM_out | Xin | Xin | Xin | Xin | Xin | MAR=1 | x | x | x | x | x | x | x | x | x | x | x | x | x | x | x | x
reg to reg | ALU_out | ALU_out | REGin | REGin | REGin | REGin | REGin | ALUOP | ALUOP | ALUOP | ALUOP | REGLaddr | REGLaddr | REGLaddr | REGRaddr | REGRaddr | REGRaddr | x | x | x | x | x | x | x
reg to ram[MAR] | ALU_out | ALU_out | RAMin | RAMin | RAMin | RAMin | RAMin | ALUOP | ALUOP | ALUOP | ALUOP | REGLaddr | REGLaddr | REGLaddr | REGRaddr | REGRaddr | REGRaddr | x | x | x | x | x | x | x
reg to ram[#0-127] | ALU_out | ALU_out | RAMZPin | RAMZPin | RAMZPin | RAMZPin | RAMZPin | ALUOP | ALUOP | ALUOP | ALUOP | REGLaddr | REGLaddr | REGLaddr | REGRaddr | REGRaddr | REGRaddr | ZPADDR | ZPADDR | ZPADDR | ZPADDR | ZPADDR | ZPADDR | ZPADDR
reg to other regX | ALU_out | ALU_out | Xin | Xin | Xin | Xin | Xin | ALUOP | ALUOP | ALUOP | ALUOP | REGLaddr | REGLaddr | REGLaddr | REGRaddr | REGRaddr | REGRaddr | x | x | x | x | x | x | x
load reg | UART_out | UART_out | REGin | REGin | REGin | REGin | REGin | x | x | x | x | x | x | x | x | x | x | x | x | x | x | x | x | x
load ram[#0-127] | UART_out | UART_out | RAMin | RAMin | RAMin | RAMin | RAMin | x | x | x | x | x | x | x | x | x | x | ZPADDR | ZPADDR | ZPADDR | ZPADDR | ZPADDR | ZPADDR | ZPADDR
load ram mar | UART_out | UART_out | RAMin | RAMin | RAMin | RAMin | RAMin | x | x | x | x | x | x | x | x | x | x | x | x | x | x | x | x | x
load other reg | UART_out | UART_out | Xin | Xin | Xin | Xin | Xin | x | x | x | x | x | x | x | x | x | x | x | x | x | x | x | x | x
 | See also 74381
0 | A MINUS B |  | 0 = A - A | with carry in/out |  |  |  | IN |  |  | OUT
1 | A PLUS B |  |  | with carry in/out |  |  |  | A | 8 |  | D | 8
2 | A DIV B |  |  |  |  |  |  | B | 8 |  | Carry | Result
3 | A MULT B LO |  |  | with carry in/out |  |  |  | OPS | 4 |  | Overflow | Result
4 | A MULT B HI |  |  | with carry in/out |  |  |  | CARRAY | 1 |  | Negative | Result
5 |  |  |  |  |  |  |  |  | 21 | 2097152 | Zero | Result
6 | A OR B |  | A = A OR A |  |  |  |  |  |  |  | Equal | Compare
7 | A AND B |  | A = A AND A |  |  |  |  |  |  |  | GT | Compare
8 | A NAND B |  | NOT A = A NAND A |  |  |  |  |  |  |  | LT | Compare
9 | A NOR B |  | NOT A = A NOR A
10 | A XOR B |  | NOT A = A XOR 1
11 | A LSL |  |  | A - 1
12 | A LSR |  |  | A + B + 1
13 | A ASR
14 | A ROR
15 | A ROL
 |  |  |  |  |  |  |  |  |  |  | REGL=A/B/C/D/RAM/ROM |  |  | REGR=A/B/C/D/ROM
 | 0 | 1 | 2 | 3 | 4 | 5 | 6 | 7 | 0 | 1 | 2 | 3 | 4 | 5 | 6 | 7 | 0 | 1 | 2 | 3 | 4 | 5 | 6 | 7
 | READ | READ | WRITE | WRITE | WRITE | WRITE | x | x | OPER | OPER | OPER | OPER | OPER | OPER | OPER | OPER
load immed | ROM_out | ROM_out | REGin | REGin | REGin | REGin | x | x | DATA | DATA | DATA | DATA | DATA | DATA | DATA | DATA
load immed | ROM_out | ROM_out | RAMin | RAMin | RAMin | RAMin | x | x | DATA | DATA | DATA | DATA | DATA | DATA | DATA | DATA
load immed | ROM_out | ROM_out | Xin | Xin | Xin | Xin | x | x | DATA | DATA | DATA | DATA | DATA | DATA | DATA | DATA
ram out[#0-255] | RAM_out | RAM_out | Xin | Xin | Xin | Xin | x | MAR=0 | LOADDR | LOADDR | LOADDR | LOADDR | LOADDR | LOADDR | LOADDR | LOADDR
ram out[MAR] | RAM_out | RAM_out | Xin | Xin | Xin | Xin | x | MAR=1 | x | x | x | x | x | x | x | x
reg to reg | ALU_out | ALU_out | REGin | REGin | REGin | REGin | ALUOP | ALUOP | ALUOP | ALUOP | REGLaddr | REGLaddr | REGLaddr | REGRaddr | REGRaddr | REGRaddr |  |  |  |  |  |  |  |  | 6x5=30
reg to ram[MAR] | ALU_out | ALU_out | RAMin | RAMin | RAMin | RAMin | ALUOP | ALUOP | ALUOP | ALUOP | REGLaddr | REGLaddr | REGLaddr | REGRaddr | REGRaddr | REGRaddr
reg to ram[#0-127] | ALU_out | ALU_out | RAMZPin | RAMZPin | RAMZPin | RAMZPin | ALUOP | ALUOP | ALUOP | ALUOP | REGLaddr | REGLaddr | REGLaddr | REGRaddr | REGRaddr | REGRaddr
reg to other regX | ALU_out | ALU_out | Xin | Xin | Xin | Xin | ALUOP | ALUOP | ALUOP | ALUOP | REGLaddr | REGLaddr | REGLaddr | REGRaddr | REGRaddr | REGRaddr
load reg | UART_out | UART_out | REGin | REGin | REGin | REGin | x | x | x | x | x | x | x | x | x | x
load ram[#0-255] | UART_out | UART_out | RAMin | RAMin | RAMin | RAMin | x | x | x | x | x | x | x | x | x | x
load ram mar | UART_out | UART_out | RAMin | RAMin | RAMin | RAMin |  | x | x | x | x | x | x | x | x | x
load other reg | UART_out | UART_out | Xin | Xin | Xin | Xin |  | x | x | x | x | x | x | x | x | x

Sheet: Sheet4
0 | OUT | OUT | ROM/RAM/UART/ALU
1 |  | OUT | ROM/RAM/UART/ALU
2
3
4 | IN | MARLO
5 |  | MARHI
6 |  | PCHI
7 |  | JMP
0 |  | RAM
1 |  | ZP
2 |  | REG
3 |  | UART
4 | ALU | REGW
5 |  | REGW
6 |  | REGW
7 | ALU | REGL
0 |  | REGL
1 |  | REGL
2 | COND | REGR
3 |  | REGR
4 |  | REGR
5 |  | COND
6 |  | COND
7 |  | COND

Sheet: Sheet3
## | d | d | c | b | a |  | DEVICE
0 | 0 | 0 | 0 | 0 | 0 |  | NOOP
1 | 0 | 0 | 0 | 0 | 1 |  | RAMin |  |  |  | ALUOP | ALULEFT | ALURIGHT | ALUWRITE | WRITE | READ
2 | 0 | 0 | 0 | 1 | 0 |  | RAMZPin |  | Consider conditional ops
3 | 0 | 0 | 0 | 1 | 1 |  | MARLOin |  | RAM = A+B IF CS |  | ALUOP=+ | A | B |  | RAMin if CS already set
4 | 0 | 0 | 1 | 0 | 0 |  | MARHIin |  | A = A-B |  | ALUOP=- | A | B | A | REGin
5 | 0 | 0 | 1 | 0 | 1 |  | UARTin |  | A = $0012 |  | direct RAMH=0 | direct RAML=$12 |  |  | REGin | RAMout |  | FYI | A = $1234 |  | synthesised by compiler to set MARHI and MARLO
6 | 0 | 0 | 1 | 1 | 0
7 | 0 | 0 | 1 | 1 | 1 |  | REGAin |  | MARHI = $12 |  |  |  |  |  | MARHIin | ROMout |  | FYI | MAR = $1234 |  | synthesised by compiler to set MARHI and MARLO
8 | 0 | 1 | 0 | 0 | 0 |  | REGBin |  | A = RAM |  |  |  |  | A | REGin | RAMout
9 | 0 | 1 | 0 | 0 | 1 |  | REGCin |  | RAM = #45 |  |  |  |  |  | RAMin | ROMout
10 | 0 | 1 | 0 | 1 | 0 |  | REGDin
11 | 0 | 1 | 0 | 1 | 1 |  | REGEin
12 | 0 | 1 | 1 | 0 | 0 |  | REGFin
13 | 0 | 1 | 1 | 0 | 1 |  | REGGin
14 | 0 | 1 | 1 | 1 | 0 |  | REGHin
15 | 0 | 1 | 1 | 1 | 1 |  | PCHITMPin |  | load tmp
16 | 1 | 0 | 0 | 0 | 0 |  | BUN |  | unconditional - load low off bus and hi from tmp
17 | 1 | 0 | 0 | 0 | 1 |  | BFN |  | flag negative |  |  |  | The comparator jumps can be synthesised from other ops
18 | 1 | 0 | 0 | 1 | 0 |  | BFZ |  | flag zero |  |  |  | BGT | comparator |  | A>B is same as B-A and BNE
19 | 1 | 0 | 0 | 1 | 1 |  | BFC |  | flag carry |  |  |  | BLT | comparator |  | A<B is same as A-B and BNE
20 | 1 | 0 | 1 | 0 | 0 |  | BFO |  | flag overflow |  |  |  | BEQ | comparator |  | A=B is same as A-B an BFZ
21 | 1 | 0 | 1 | 0 | 1 |  | BDI |  | data in
22 | 1 | 0 | 1 | 1 | 0 |  | BDO |  | data out
23 | 1 | 0 | 1 | 1 | 1
24 | 1 | 1 | 0 | 0 | 0
25 | 1 | 1 | 0 | 0 | 1
26 | 1 | 1 | 0 | 1 | 0
27 | 1 | 1 | 0 | 1 | 1
28 | 1 | 1 | 1 | 0 | 0
29 | 1 | 1 | 1 | 0 | 1
30 | 1 | 1 | 1 | 1 | 0
31 | 1 | 1 | 1 | 1 | 1
 |  |  |  |  |  |  |  |  |  |  |  | 0 | 1 | 2 | 3 | 4 | 5 | 6 | 7 | 0 | 1 | 2 | 3 | 4 | 5 | 6 | 7
 |  |  |  |  |  |  |  |  |  |  |  |  |  |  |  |  |  |  |  |  |  |  |  |  | Condit | Condit | Condit
 |  |  |  |  |  | 1 | NOOP |  |  |  |  | 1 | RAMin |  |  |  |  |  |  |  |  |  |  |  | Condit | Condit | Condit
 |  |  |  |  |  | 2 | RAMin |  |  |  |  | 2 | MARLOin |  |  |  |  |  |  |  |  |  |  |  | Condit | Condit | Condit
 |  |  |  |  |  | 3 | RAMZPin |  |  |  |  | 3 | MARHIin |  |  |  |  |  |  |  |  |  |  |  | Condit | Condit | Condit
 |  |  |  |  |  | 4 | MARLOin |  |  |  |  | 4 | UARTin
 |  |  |  |  |  | 5 | MARHIin |  |  |  |  | 5 | REGAin
 |  |  |  |  |  | 6 | UARTin |  |  |  |  | 6 | REGBin
 |  |  |  |  |  | 7 | REGAin |  |  |  |  | 7 | REGCin
 |  |  |  |  |  | 8 | REGBin |  |  |  |  | 8 | REGDin
 |  |  |  |  |  | 9 | REGCin |  |  |  |  | 9 | PCHITMPin
 |  |  |  |  |  | 10 | REGDin |  |  |  |  | 10 | BUN
 |  |  |  |  |  | 11 | PCHITMPin |  |  |  |  | 11 | BFN
 |  |  |  |  |  | 12 | BUN | = | JMP $LO | unconditional | 0 | 12 | BFZ
 |  |  |  |  |  | 13 | BFN | = | JMP $LO | if FN | 1 | 13 | BFC
 |  |  |  |  |  | 14 | BFZ | = | JMP $LO | if FZ | 2 | 14 | BFO
 |  |  |  |  |  | 15 | BFC | = | JMP $LO | if FC | 3 | 15 | BDI
 |  |  |  |  |  | 16 | BFO | = | JMP $LO | if FO | 4 | 16 | BDO
 |  |  |  |  |  | 17 | BDI | = | JMP $LO | if DI | 5
 |  |  |  |  |  | 18 | BDO | = | JMP $LO | if DO | 6
 |  |  |  |  |  |  |  |  |  | XXX | 7

Sheet: AVR like
 | PCLOin | PCHIin | PCHItmp | REGin | MARLOin | MARHIin | UARTin | RAMin |  |  |  |  |  |  |  |  | UARTout | RAMout | ROMout | ALUout
 | BUS_WR |  |  |  | BUS_RD | Device read from bus
 | 0 | 0 | ROMout |  | 0 | 0 | 0 |  |  | noop
 | 0 | 1 | RAMout |  | 0 | 0 | 1 | REGin |  | write to a reg
 | 1 | 0 | UARTout |  | 0 | 1 | 0 | RAMin |  | write to ram
 | 1 | 1 | ALUout |  | 0 | 1 | 1 | PCHiIn |  | load hi jmp address
 |  |  |  |  | 1 | 0 | 0 | PCJmpIn |  | load lo and commit hi jmp
 |  |  |  |  | 1 | 0 | 1 | MARLOin |  | load lo ram
 |  |  |  |  | 1 | 1 | 0 | MARHIin |  | load hi ram
 |  |  |  |  | 1 | 1 | 1 | UARTin
Free bits for more registers??
 |  |  |  |  |  |  |  |  |  |  |  |  |  |  |  |  |  | 0 | DEV=ROM
 |  |  |  |  |  |  |  |  |  |  |  |  |  |  |  |  |  | 1 | DEV=RAM[ZP]
 | 0 | 1 | 2 | 3 | 4 | 5 | 6 | 7 | 0 | 1 | 2 | 3 | 4 | 5 | 6 | 7 |  | 2 | DEV=RAM[MAR]
 | OP | OP | IDX MODE | DEST | DEST | DEST | DEST | DEST | OPER | OPER | OPER | OPER | OPER | OPER | OPER | OPER |  | 3 | REGX=ALU(REGX,REGY)
DEVICE=ROM | ROM_out | ROM_out | X | DEVICE | DEVICE | DEVICE | DEVICE | DEVICE | DATA | DATA | DATA | DATA | DATA | DATA | DATA | DATA |  | 4 | RAM[ZP]=PASS(REGX)
 |  |  |  |  |  |  |  |  |  |  |  |  |  |  |  |  |  | 5 | RAM[MAR]=PASS(REGX)
DEVICE=ram out[#0-255] | RAM_out | RAM_out | 0 | DEVICE | DEVICE | DEVICE | DEVICE | DEVICE | PGZERO | PGZERO | PGZERO | PGZERO | PGZERO | PGZERO | PGZERO | PGZERO |  | 6 | DEV=UART
DEVICE=ram out[MAR] | RAM_out | RAM_out | 1 | DEVICE | DEVICE | DEVICE | DEVICE | DEVICE | x | x | x | x | x | x | x | x |  | 7 | RAM[ZP]=UART
 |  |  |  |  |  |  |  |  |  |  |  |  |  |  |  |  |  | 8 | RAM[MAR]=UART
When ALU_OUT then decoder bit E is always 1 thereofr but 2 & 3 of opcode can be additional decoding for where result gets written : Bit3 ? 1 means back to REGX, 0 means to RAM, Bit2: RamIndex mode
REGX=ALUOP(REGX,REGY) | ALU_out | ALU_out | 0 | 0 | REGX | REGX | REGX | REGX | ALUOP | ALUOP | ALUOP | ALUOP | REGY | REGY | REGY | REGY |  | 9
RAM[ZP]=PASS(REGX) | ALU_out | ALU_out | 0 | 1 | REGX | REGX | REGX | REGX | PGZERO | PGZERO | PGZERO | PGZERO | PGZERO | PGZERO | PGZERO | PGZERO |  | a
RAM[MAR]=ALUOP(REGX,REGY) | ALU_out | ALU_out | 1 | 0 | REGX | REGX | REGX | REGX | ALUOP | ALUOP | ALUOP | ALUOP | REGY | REGY | REGY | REGY |  | b
UART=ALUOP(REGX,REGY) | ALU_out | ALU_out | 1 | 1 | REGX | REGX | REGX | REGX | ALUOP | ALUOP | ALUOP | ALUOP | REGY | REGY | REGY | REGY
Bit2 relevant only when writing to RAM 00011 |  |  |  |  |  |  |  |  |  |  |  |  |  |  |  |  |  | c
RAM[PGZERO]=UART | UART_out | UART_out | 0 | 0 | 0 | 0 | 1 | 1 | PGZERO | PGZERO | PGZERO | PGZERO | PGZERO | PGZERO | PGZERO | PGZERO |  | f
RAM[MAR]=UART | UART_out | UART_out | 1 | 0 | 0 | 0 | 1 | 1 | x | x | x | x | x | x | x | x
DEVICE=UART | UART_out | UART_out | x | DEVICE | DEVICE | DEVICE | DEVICE | DEVICE | x | x | x | x | x | x | x | x
 | See also 74381
0 | A MINUS B |  | 0 = A - A | with carry in/out |  |  |  | IN |  |  | OUT
1 | A PLUS B |  |  | with carry in/out |  |  |  | A | 8 |  | D | 8
2 | A DIV B |  |  |  |  |  |  | B | 8 |  | Carry | Result
3 | A MULT B LO |  |  | with carry in/out |  |  |  | OPS | 4 |  | Overflow | Result
4 | A MULT B HI |  |  | with carry in/out |  |  |  | CARRAY | 1 |  | Negative | Result
5 |  |  |  |  |  |  |  |  | 21 | 2097152 | Zero | Result
6 | A OR B |  | A = A OR A |  |  |  |  |  |  |  | Equal | Compare
7 | A AND B |  | A = A AND A |  |  |  |  |  |  |  | GT | Compare
8 | A NAND B |  | NOT A = A NAND A |  |  |  |  |  |  |  | LT | Compare
9 | A NOR B |  | NOT A = A NOR A
10 | A XOR B |  | NOT A = A XOR 1
11 | A LSL |  |  | A - 1
12 | A LSR |  |  | A + B + 1
13 | A ASR
14 | A ROR
15 | A ROL
 |  |  |  |  |  |  |  |  |  |  | REGL=A/B/C/D/RAM/ROM |  |  | REGR=A/B/C/D/ROM
 | 0 | 1 | 2 | 3 | 4 | 5 | 6 | 7 | 0 | 1 | 2 | 3 | 4 | 5 | 6 | 7 | 0 | 1 | 2 | 3 | 4 | 5 | 6 | 7
 | READ | READ | WRITE | WRITE | WRITE | WRITE | x | x | OPER | OPER | OPER | OPER | OPER | OPER | OPER | OPER
load immed | ROM_out | ROM_out | REGin | REGin | REGin | REGin | x | x | DATA | DATA | DATA | DATA | DATA | DATA | DATA | DATA
load immed | ROM_out | ROM_out | RAMin | RAMin | RAMin | RAMin | x | x | DATA | DATA | DATA | DATA | DATA | DATA | DATA | DATA
load immed | ROM_out | ROM_out | Xin | Xin | Xin | Xin | x | x | DATA | DATA | DATA | DATA | DATA | DATA | DATA | DATA
ram out[#0-255] | RAM_out | RAM_out | Xin | Xin | Xin | Xin | x | MAR=0 | LOADDR | LOADDR | LOADDR | LOADDR | LOADDR | LOADDR | LOADDR | LOADDR
ram out[MAR] | RAM_out | RAM_out | Xin | Xin | Xin | Xin | x | MAR=1 | x | x | x | x | x | x | x | x
reg to reg | ALU_out | ALU_out | REGin | REGin | REGin | REGin | ALUOP | ALUOP | ALUOP | ALUOP | REGLaddr | REGLaddr | REGLaddr | REGRaddr | REGRaddr | REGRaddr |  |  |  |  |  |  |  |  | 6x5=30
reg to ram[MAR] | ALU_out | ALU_out | RAMin | RAMin | RAMin | RAMin | ALUOP | ALUOP | ALUOP | ALUOP | REGLaddr | REGLaddr | REGLaddr | REGRaddr | REGRaddr | REGRaddr
reg to ram[#0-127] | ALU_out | ALU_out | RAMZPin | RAMZPin | RAMZPin | RAMZPin | ALUOP | ALUOP | ALUOP | ALUOP | REGLaddr | REGLaddr | REGLaddr | REGRaddr | REGRaddr | REGRaddr
reg to other regX | ALU_out | ALU_out | Xin | Xin | Xin | Xin | ALUOP | ALUOP | ALUOP | ALUOP | REGLaddr | REGLaddr | REGLaddr | REGRaddr | REGRaddr | REGRaddr
load reg | UART_out | UART_out | REGin | REGin | REGin | REGin | x | x | x | x | x | x | x | x | x | x
load ram[#0-255] | UART_out | UART_out | RAMin | RAMin | RAMin | RAMin | x | x | x | x | x | x | x | x | x | x
load ram mar | UART_out | UART_out | RAMin | RAMin | RAMin | RAMin |  | x | x | x | x | x | x | x | x | x
load other reg | UART_out | UART_out | Xin | Xin | Xin | Xin |  | x | x | x | x | x | x | x | x | x

Sheet: WriteDecoder
WRITE DEST |  |  |  |  |  | 74hct138*2 - Inverting 3 to 8 decoder PLUS 1 Inverter |  | See long decoding : http://www.ti.com/lit/ds/symlink/cd74act138.pdf
E | D | C | B | A
0 | 0 | 0 | 0 | 0 | NOOP | NOOP useful for CMP operation which just sets flags |  | /REG EN LINE = 74138(E3=1,/E2=NOR(F,E),/E1=D,A2=C,A1=B,A0=A)
0 | 0 | 0 | 0 | 1 | MARLOin |  |  | /REG EN LINE = 74138(E3=1,/E2=NOR(F,E),/E1=D,A2=C,A1=B,A0=A)
0 | 0 | 0 | 1 | 0 | MARHIin |  |  | /REG EN LINE = 74138(E3=1,/E2=NOR(F,E),/E1=D,A2=C,A1=B,A0=A)
0 | 0 | 0 | 1 | 1 | RAMin | MAR/ZP determined elsewhere |  | /REG EN LINE = 74138(E3=1,/E2=NOR(F,E),/E1=D,A2=C,A1=B,A0=A)
0 | 0 | 1 | 0 | 0 | UARTin |  |  | /REG EN LINE = 74138(E3=1,/E2=NOR(F,E),/E1=D,A2=C,A1=B,A0=A)
0 | 0 | 1 | 0 | 1 |  |  |  | /REG EN LINE = 74138(E3=1,/E2=NOR(F,E),/E1=D,A2=C,A1=B,A0=A) |  | ??
0 | 0 | 1 | 1 | 0 |  |  |  | /REG EN LINE = 74138(E3=1,/E2=NOR(F,E),/E1=D,A2=C,A1=B,A0=A) |  | ??
0 | 0 | 1 | 1 | 1 |  |  |  | /REG EN LINE = 74138(E3=1,/E2=NOR(F,E),/E1=D,A2=C,A1=B,A0=A)
0 | 1 | 0 | 0 | 0 | JMP | Jump unconditionally | to [JMPPAGE,Bus] | /JMP EN LINE = 74138(E3=D,/E2=NOR(F,E),/E1=0,A2=C,A1=B,A0=A)
0 | 1 | 0 | 0 | 1 | JMPOF | Jump if overflow | to [JMPPAGE,Bus] | /JMP EN LINE = 74138(E3=D,/E2=NOR(F,E),/E1=0,A2=C,A1=B,A0=A) | AND WITH CONTROL LINE
0 | 1 | 0 | 1 | 0 | JMPZS | Jump in page if Zero set | to [JMPPAGE,Bus] | /JMP EN LINE = 74138(E3=D,/E2=NOR(F,E),/E1=0,A2=C,A1=B,A0=A) | AND WITH CONTROL LINE
0 | 1 | 0 | 1 | 1 | JMPCS | Jump in page if Carry set | to [JMPPAGE,Bus] | /JMP EN LINE = 74138(E3=D,/E2=NOR(F,E),/E1=0,A2=C,A1=B,A0=A) | AND WITH CONTROL LINE
0 | 1 | 1 | 0 | 0 | JMPDI | Jump if Data In ready | to [JMPPAGE,Bus] | /JMP EN LINE = 74138(E3=D,/E2=NOR(F,E),/E1=0,A2=C,A1=B,A0=A) | AND WITH CONTROL LINE
0 | 1 | 1 | 0 | 1 | JMPDO | Jump if Data Out ready | to [JMPPAGE,Bus] | /JMP EN LINE = 74138(E3=D,/E2=NOR(F,E),/E1=0,A2=C,A1=B,A0=A) | AND WITH CONTROL LINE
0 | 1 | 1 | 1 | 0 | JMPPAGEin | set HI byte - doesn't cause jump |  | /JMP EN LINE = 74138(E3=D,/E2=NOR(F,E),/E1=0,A2=C,A1=B,A0=A)
0 | 1 | 1 | 1 | 1 | JMPLOC | Jump local unconditional | to [=,Bus] | /JMP EN LINE = 74138(E3=D,/E2=NOR(F,E),/E1=0,A2=C,A1=B,A0=A)
1 | 0 | 0 | 0 | 0 | A | sets REGin and REGW value |  | REG W = NOR(F, NOT E) REGADDR=DCBA | Bits [d,c,b,a] defines first operand of ALU op X in ... X=X OP Y
1 | 0 | 0 | 0 | 1 | B | sets REGin and REGW value |  | REG W = NOR(F, NOT E) REGADDR=DCBA
1 | 0 | 0 | 1 | 0 | C | sets REGin and REGW value |  | REG W = NOR(F, NOT E) REGADDR=DCBA
1 | 0 | 0 | 1 | 1 | D | sets REGin and REGW value |  | REG W = NOR(F, NOT E) REGADDR=DCBA
1 | 0 | 1 | 0 | 0 | E | sets REGin and REGW value |  | REG W = NOR(F, NOT E) REGADDR=DCBA
1 | 0 | 1 | 0 | 1 | F | sets REGin and REGW value |  | REG W = NOR(F, NOT E) REGADDR=DCBA
1 | 0 | 1 | 1 | 0 | G | sets REGin and REGW value |  | REG W = NOR(F, NOT E) REGADDR=DCBA
1 | 0 | 1 | 1 | 1 | H | sets REGin and REGW value |  | REG W = NOR(F, NOT E) REGADDR=DCBA
1 | 1 | 0 | 0 | 0 | I | sets REGin and REGW value |  | REG W = NOR(F, NOT E) REGADDR=DCBA
1 | 1 | 0 | 0 | 1 | J | sets REGin and REGW value |  | REG W = NOR(F, NOT E) REGADDR=DCBA
1 | 1 | 0 | 1 | 0 | K | sets REGin and REGW value |  | REG W = NOR(F, NOT E) REGADDR=DCBA
1 | 1 | 0 | 1 | 1 | L | sets REGin and REGW value |  | REG W = NOR(F, NOT E) REGADDR=DCBA
1 | 1 | 1 | 0 | 0 | M | sets REGin and REGW value |  | REG W = NOR(F, NOT E) REGADDR=DCBA
1 | 1 | 1 | 0 | 1 | N | sets REGin and REGW value |  | REG W = NOR(F, NOT E) REGADDR=DCBA
1 | 1 | 1 | 1 | 0 | O | sets REGin and REGW value |  | REG W = NOR(F, NOT E) REGADDR=DCBA
1 | 1 | 1 | 1 | 1 | P | sets REGin and REGW value |  | REG W = NOR(F, NOT E) REGADDR=DCBA
