Johnlon/spam-1/docs/instruction_bitfield.md

# Instruction bitfield

Instruction bits

See [Control Logic](control_logic.md) for how each field is decoded.
