Johnlon/spam-1/docs/wavedrom-test.md

signal step4

signal step5

```html
<img src="https://svg.wavedrom.com/{signal:[{name:'clk',wave:'p......'},{name:'bus',wave:'x.34.5x',data:'head body tail'},{name:'wire',wave:'0.1..0.'}]}"/>
```
