Johnlon/spam-1/(threads)

Thread 3 (2022-01-11):

LICENSE?

metaflow, 2022-01-11:
Hi! I would love to use some of the code you have here. Could you please specify under which license is this repo?

Johnlon, 2022-01-17:
Hi glad it's useful
I'll add a permissive license.
Which bit you interested in?

metaflow, 2022-01-18:
I wanted to use verilog definitions for 74xx modules if you don't mind. But as there is no licensing, I don't want to step over.

Johnlon, 2022-01-20:
Thanks for doing the decent thing.

Let me fix.

--

Out of curiosity what is it that you like about them. Is it merely the
functionality or my attempts and realistic delays?

The honest truth is that when I was looking for this kind of stuff I was a
bit disappointed that the community wasn't building a big library of
good quality realistic models. Lots I found were full of bugs or the
models were not pip for pin accurate, or the RAM's were dual-ported rather
than tristate.
It all seems fragmented and duplicative and if you fork this and fix things
then the community doesn't benefit?

Would you be interested in helping to make this happen - in which case I
would split the models off into a separate github and you could use for
example a git submodule to pull them in? (
https://git-scm.com/book/en/v2/Git-Tools-Submodules)

Any ideas?

In any case I'll fix the license.

John

On Tue, 18 Jan 2022 at 08:48, Mikhail Goncharov ***@***.***>
wrote:

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

metaflow, 2022-01-20:
@Johnlon yes, I found your repository mostly by searching for 74 series verilog definitions. I have a CPU project in mind (as you have) but it's still a bit early stages and I am considiring different tools / workflows.

At one point I was thinking that it would be possible to go back and forth of formal definition and schematics by using logsim evolution but it looks like it needs a propiatary sofware to simulate schematics. "Digital" also does not work like that. So now I am back to just Icarus Verilog and will likely use EasyEDA schematics only for illustrative purposes and do all simulations in verilog.

As for not forking everything - sure, as soon as I have something working I will try to come back to you to contirubute back.
One question I had about definitions: why you don't fix the number of pins to "reality"? Is it easier to test this way?

Johnlon, 2022-02-22:
Fixed

Johnlon, 2022-02-22:
@metaflow  "One question I had about definitions: why you don't fix the number of pins to "reality"? Is it easier to test this way?"

Sorry what model are you refetrring to?

Closed 2022-05-24.

Thread 4 (2022-05-24):

Can I use your UART with verilator?

theboywhomakesgames, 2022-05-24:
Hi John.
Thank you for your amazing repo!

I don't have access to an FPGA and am trying to build something like spam-1 on verilator. I'm starting with the UART and am trying to use your implementation of it.

The thing is that verilator is run on c++ and can't possibly pass data to the UART module in a 9600 bits/sec speed. Do I NEED to choose a lower speed to be able to do this or am I doing something wrong?

Johnlon, 2022-05-24:
Spam-1 is a breadboard build btw and I have no experience of fpga.

I use verilog as it allowed me to simulate all the 7400 components during the build.

The uart model I wrote for the ftdi device was useful for my Sims as I can interact with it over a file.

I don't know how useful it would be for your use case. I don't consider baud rates when thinking about this stuff because like I say the "terminal" in my case are files not a serial cable.

Perhaps some more info.

Johnlon, 2022-05-24:
Also since I use Icarus verilog and not verilator there will be mods needed.

It would be good if these could be added to my model using #defines rather than creating an disconnected model if possible.

I can't exactly recall why I don't use verilator - I'm sure there was a reason. Icarus verilog isn't super fast tho it does allow me to run with realistic propagation delays which has helped spot errors.

Johnlon, 2022-05-25:
Icarus can take input from the console if you want to interact with the
simulation.

Baud has nothing to do with my uart model. It's just a model of a uart that
behaves like a um245r to the rest of the verilog SIM and connects to file
io on the local filesystem for external interactive things. There is no
terminal and no serial line so no baud.

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

theboywhomakesgames, 2022-05-25:
Got it!

Thank you so much for your help.

On Wed, May 25, 2022, 7:14 AM John Lonergan ***@***.***>
wrote:

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
