Johnlon/spam-1/(list of files, drawings)

Other design files:
logism/ALU_external_cin_logic.circ
logism/ALU_with_carry_in2.circ
logism/ALU_with_carry_in.circ
logism/CPU20_RELEASE.circ
logism/CPU21.circ
logism/CPU21_EXPERIMENT_WITH_BRANCH.circ
logism/CPU21_NO_IR.circ
logism/CPU21_PC_AS_COUNTING_REG.circ
logism/CPU21_RUNNING_JOHNNYS_COUNTER_PROG.circ
logism/fred.circ
logism/LevelToPulseConverter.circ
logism/OpenCollectorDemo.circ
