Johnlon/spam-1/jvmtools/compiler/programs/print_data.asm

; run and grep "TRANS" to see uart transmit message

; LOAD TO RAM AT THE CURRENT MEMORY[0] ONWARDSa AND SET THE LABEL TO THE FIRST BYTE
STRING_DATA:     STR     "Hello World\0"

            PCHITMP = 0

            MARHI= < :STRING_DATA
            MARLO= > :STRING_DATA

loop:
            REGC=RAM _S
            PC = >:end _Z

            REGD=>:loop

            MARLO = MARLO + 1 _S
            MARHI = MARHI + 1 _C

            PC      = >:send_uart


send_uart:  PC      = >:transmit _DO
            PC      = >:send_uart    ;loop wait

transmit:   UART=REGC
            PC = REGD
end:

END
