Johnlon/spam-1/(commit log)

2019-08-03 added logism components
    [CPU20_RELEASE.circ, OpenCollectorDemo.circ]
2019-08-18 added comments on CPU arch to readme
    [CPU21.circ]
2019-08-18 more chips
    [CPU21_NO_IR.circ, CPU21_PC_AS_COUNTING_REG.circ]
2019-08-19 added PC documentation
    [CPU21_PC_AS_COUNTING_REG.circ]
2019-08-23 arch docs
    [CPU21_EXPERIMENT_WITH_BRANCH.circ, CPU21_RUNNING_JOHNNYS_COUNTER_PROG.circ]
2019-08-28 added ALU design page
    [ALU_external_cin_logic.circ, ALU_with_carry_in.circ, ALU_with_carry_in2.circ, fred.circ]
2019-09-07 more components details and some research
    [MouserSRAMList.csv]
2019-09-19 more verilog
    [ALU_external_cin_logic.circ, ALU_with_carry_in.circ, ALU_with_carry_in2.circ, CPU20_RELEASE.circ, CPU21.circ, CPU21_EXPERIMENT_WITH_BRANCH.circ, CPU21_NO_IR.circ, CPU21_PC_AS_COUNTING_REG.circ]
2020-03-06 Added docs and verilog stuff and data sheets
    [LevelToPulseConverter.circ, SPAM1-16-instruction-set.xlsx, SPAM1-AVR-Like.xlsx]
2020-03-12 basic control logic working
    [SPAM1-AVR-Like-ALL-ALU.xlsx, SPAM1-AVR-Like.xlsx, SPAM1-AVR-Like1.xlsx]
2020-03-12 stsrted added UART section but logic is too difficult - will change strategy
2020-03-13 new decode approach with tests - still needs todo fixes and translation of code to logic - may be better as a rom if it fits?
    [control.v, test.v]
2020-03-18 basic alu working and control
    [SPAM1-AVR-Like.xlsx]
2020-03-31 added uart
2020-03-31 added uart tests
2020-03-31 added uart timing 50ns
2020-04-01 work around specify timings not working
    [test.v]
2020-04-01 fixed contention issue caused by ram
    [test.v]
2020-04-02 added assembler
2020-04-11 added assembler and test_gen.py test generator
2020-04-11 swithed from pulldown to tri0 due to new icarus 'bug' https://github.com/steveicarus/iverilog/issues/316
    [test.v]
2020-04-11 demo of pulldown error
    [test.v]
2020-04-11 added experiment showing OR glitch when gating
    [test.v]
2020-04-20 uart remote working
2020-04-21 uart working
2020-04-26 fix assembler
2020-05-07 complex uart tx/rx works
    [SPAM1-AVR-Like.xlsx]
2020-05-19 added sr flip flop
    [test.v]
2020-05-19 work prior to rework - notes and stuff - probablyt delete file
    [control_selector.v]
2020-05-21 added control logic for PC and phasing seems to work
    [SPAM1-AVR-Like.xlsx]
2020-05-28 adding device sel logic
2020-05-30 small fixes in op_decoder
    [control.v]
2020-06-01 sync reset with clock so we get a full initial fetch period
    [control.v, test.v]
2020-06-09 tested dev_eq_rom_immed / dev_eq_const8 / dev_eq_xy_alu needed to add path from IR to RBUS
    [SPAM1-20200527.xlsx, SPAM1-AVR-Like.xlsx]
2020-06-13 added ALU back in
    [SPAM1-20200527.xlsx]
2020-06-13 added ram[immed16]=device
2020-06-15 small changes
    [SPAM1-20200527.xlsx]
2020-06-15 switched from immediate to direct
2020-06-16 added pseudo assemble two commits ago
2020-06-16 wired in the reg file
2020-06-19 writen up ALU to use two complement, to use GT/LT outputs, to have ops 9/10/11 fixes as arith without carry, to have the special op be an arithmetic comparison + ALSO + moved devices around to make t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
    [control.v, test.v]
2020-06-22 fixed names of devices
    [control.v]
2020-06-24 broke up the control code into separate files
    [control.v]
2020-06-24 changed logic so that indeterminate values of A do not propagate when then enable pin are disabled
2020-06-29 loop counter program working - found bug in reg file wiring that caused a loop that interfered in counting (clk needed to wire to exec and not to system clock) - however there are bugs due to ALU not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
    [SPAM1-20200527.xlsx]
2020-06-30 works now with using A_PLUS_B / previously using B_PLUS_1 but that didn't use carry so changed to A+B to see diff in code - needs an extra instruction to ensure carry is cleared ----- also added inst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
    [loop.v, test.v, wide_controller.v]
2020-07-05 added UART - writing works
2020-07-05 looping now writes to UART
2020-07-05 removed uart.control
2020-07-09 no longer carry in on shift ops
    [test.v]
2020-07-14 added make alu_ops a package not a module and fix usaages of A+B to use carry when needed
    [loop.v, test.v]
2020-07-14 fixed uart control
2020-07-15 split out the assembler.v
2020-07-18 fixed PC test that was broken
    [test.v]
2020-07-22 removed duplicative ALU ops and replaced by BCD_OPS
    [loop.v, test.v]
2020-07-23 fixed problem where 6502 ROL and ROR used carry_in which I dont have available on the ROM at present so changed the ops to Z80 RRC/RLC
    [test.v]
2020-07-25 alu code and rom version equate now
    [SPAM1-20200527.xlsx]
2020-07-26 added the external logic for the alu - including kicad schema
    [alu_ext_logic.kicad_pcb, alu_ext_logic.sch]
2020-08-06 works - added pull downs to busses but stil tri0 on addressbus not working so using pulldown() instead
    [test.v, wide_controller.v]
2020-08-07 taken latest iverilog update to fix tri0 issues / also cleaned up the pc
    [counterReg.v, loop.v, test.v, testChained.v]
2020-08-07 PC now uses a more conventional chaining pattern / added more tests to counterReg as it ought to work like an 8bit 74163
2020-08-12 cleanup including removing the rom device and using immed instead
2020-09-10 simplified wiring of enable pins
2020-09-14 save before changing the cpu to 4 bits device and conditional instruction
    [devices.xlsx]
2020-09-15 reorg part 1 - need to tidy up component length in instruciton, fix decode logic, and also add conditionals
    [test.v, wide_controller.v]
2020-09-23 shortend A/B/T to 2/2/4 bits
    [wide_controller.v]
2020-09-23 fix field lens
2020-10-17 updated everything to pass verilator linter checks and revitalised some broken tests
    [assemble.py, demo.v, disassembler.v, generate_tests.py, psuedo_assembler.sv, test.v, testChained.v]
2020-11-01 added delay on _RXF and also suppress console printing of x
2020-11-01 added corrected external logic using nand gates and timings and fixed false glitch
    [test.v]
2020-11-03 added COMMENT facility in pseudo assembler
2020-11-04 fixed flag control logic issue that caused a glitch the made the flags load at wrong time
    [demo_counting_and_misc.v, test.v]
2020-11-04 switch gated_flags_clk to NOR
2020-11-05 fixed a bug in the rom image for 0+0- : so my physical ROM has a bug gs
    [test.v]
2020-11-08 ading assembler
2020-11-08 add assembler
2020-11-09 convert assembler ot scala and base on 6502
2020-11-14 assembler working / need to fix rought edge
2020-11-19 imported new assembler and added failng test for setting of flags when instruction isnt enabled to run
2020-11-19 moved assembler here
2020-11-23 print_data_using_stack.asm works
2020-11-23 print_data_using_stack.asm works. takes 96us per uart char approx therefore 10k / second uart out which it painting a screen of 120 chars wide means about 80 lines a second
2020-11-23 print_data.asm now works
2020-11-26 validate asm by assembling it
2020-11-28 supports var X = Y + Z
    But, I've left tests failing because the other test cases WERE correct & reasonable, and are breaking now only because I've generalised the algorithm to handle the more complex cases and this doubles code size.
    Fix: add some special cases in the compiler to give those simple cases a more specific solution eg for "var a = 1" or "return var" we don't need a temp ram store.
    def main(): void = {
    var a = 0
    var a = a + 1
    var b = 4 + (a + 5)
    putchar(b)
    }
    [t1.asm]
2020-12-02 static function call wiring working using static RAM variabl2es - no use of stack so no reentrant calls.
2020-12-06 adding string vars - need to get STR into the assembler
2020-12-08 commented out assembler check where I have a functional check
2020-12-09 added terminal for UART out and fixed jump bug when TX not ready
2020-12-10 switch to using case classes
2020-12-11 uart control file s now configurable
2020-12-13 switched to signed comparisons in 8 bits
2020-12-18 still working - switched to my own little U8 class
2020-12-18 BC_Test prints "Bon by best coder"
2020-12-22 switched to a interpreter approach - simpler
2020-12-23 switching to one draw essage per instruction rather than lots of pixel events
2020-12-30 >50% done - need to commit to split the case classes from the parser
2020-12-31 I've discovered that 16 bit >> or << isn't doable with my ALU with simply shifting out from the first byte into the second. so I have to filter ths bit out first and add back later. I knew that multi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
2021-01-14 uart docs
2021-02-09 checked hardware wires vs model and marked controller statements as checked DONE
2021-03-04 repaired verilog due to wiring changes to controller
2021-03-06 added halt instruction to Scc and to the assembler and the verilog removed junk files
2021-03-11 changed sim to match wiring of reset to PC in hardware
    [demo_counting_and_misc.v, test.v]
2021-03-12 clk wires cleanup
2021-03-31 updated to use a case class for the Halt value
2021-03-31 switched to using INSTRCTION
2021-04-02 UART now prints periodically when running to remind me its there
2021-04-15 names changes to be more consistent and tally with the schematic
2021-04-18 switched the abus/bbus select logic for the reg file to use a single line not the 7, ie it no uses the topmost abus/bbus_dev bit rather than anding the four reg specific lines
2021-04-20 wiring tidy
2021-04-27 renamed to match schematic
2021-06-02 use of ~! in parser to make error messages more local renamed V2 reg to TMP2 UART teminal better error handling on threads
2021-06-06 added additional 8 BDEV devices and added RAND device
2021-06-06 added additional 7 BDEV devices added rand to scc and verilog
2021-06-13 disasm sent to UART term - but need to move this to the uart term as it eats Verilog cpu cycles
2021-06-17 cleanup uart term
2021-07-10 reversed flag bit logic to make hardware simpler with fewer chips
    [psuedo_assembler.sv]
2021-07-19 MAJOR MILESTONE - TETRIS IS WORKING !! Need to add random and countdown timer and also input from ComTerminal.
2021-09-17 added ports to assembler / added read port to spamcc need to add writing need to finish the verilog sim to read/write the ports
2021-09-20 need to add writing to the port finished the verilog sim to read the ports Need to do reading from the random device
2021-10-05 switched PORT and PORTSEL so port is on same position on B and T devices end of program is not Haltcode(65535, 255)
    need to finish the verilog sim to write the ports - needs the hw coded in verilog
2021-11-27 added raw cut of cpu.js
2021-12-06 use tdev4 bit as part of tdev device
2021-12-13 ALU - added a code version of the ALU glue logic
2021-12-14 don't commit the uart control files
2021-12-14 Corrected the run prog scripts
    [TestProg.scc.asm]
2022-01-09 added timers to Kotlin CPU simulator on a Timer1 port Chip8 emulator uses a call to the Timer1 port so won't work on verilog anymore until it's fixed
    [Main.kt]
2022-01-09 added a software version of the timer, not chips yet
2022-02-21 fixed accidental halt in middle of chip8 code
    [Main.kt]
2022-05-25 added RESERVE and noticed that the impl for initialised data messes up the labels cos inserting initialised data at the program start pushes the program labels forward BU THIS IS AFTER the label addr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
2022-06-07 verilog - need to check the order of the H/W status flags is czonENGL and not something else because I'd forgotten to update the verilog but the kotlin and asm were right it was GLEN but I think the 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
    assembler = better logging
2022-06-08 vbcc compiler integrated with Assembler and Simulator
2022-07-19 renovated AssemblerTest
2022-07-27 render uart out from the sim
2022-09-09 corrected the order of the amode and condmode in certain files
    [psuedo_assembler.sv]
2026-10-01 WIP: gradle changes, hand-written pages landing page
